bty1987/KeyCore/02-结构图纸/README.md

# 透明键盘 · 结构图纸说明（v5.0 · 侧磁 Maglev，2026-10-02）

> **★ 2026-10-07 重生成（现行，与下文冲突时以本条为准）**：
> 厚板 **v4 = 300.2×192×9**（与 PCB 同高同宽、四角 R4）**67 孔打穿**（2026-10-04 拍板），
> **孔心 = EDA 实测霍尔位 H01~H67**（用户拍板：v5.1"+4 预放偏置"弃用，霍尔位即键位）；
> 磁道 73 条（缝道 61 自空格侧板缘开通 + 行端道 12），边缘开口盲槽 z3~7 → **CNC**。
> 订购图 `07-PCB/output/厚板订购图-V6-打穿版-20261007.svg` 与 scad 同源同值。
> **CSV v5.2 的 x/y 列已过时**（键位其后多次手动下移，EDA=CSV−11.337mm），仅 **w_u 键宽列**可用；权威坐标 = EDA 实测霍尔位。

> **v5.0 大改版（2026-10-02 晚）**：复刻 Flux 键帽侧磁方案——每键 2×N52 4×2 嵌**键帽左右侧壁**（N 朝下），
> 霍尔移到**左侧磁铁正下方**，悬浮回弹改**键帽间侧壁互斥**，板侧磁铁全部取消，6×3 感应磁铁退役为备件。
> 旧版图纸（structure.scad 穿脖三件套 / 三段式键帽 / 框架板 / 厚板 v3.0 块底磁铁版）已全部删除，本目录即唯一现行版。

本目录 4 个文件，数据同源（同一份 67 键 CSV）：

| 文件 | 用途 | 状态 |
|---|---|---|
| `thickplate-v4.scad` | **厚板通孔板(67 孔打穿) + 键帽块 + 试装板**（thick_plate / keycap_block / test_plate，宽键 `-D key_wu=2.25` 等） | ✅ 2026-10-07 按 EDA 霍尔位重生成；v3 盲孔版已删 |
| `chassis-v3.2.scad` | 底壳 | ⚠ 仍为 314.2×201.4 时代值，待按 300.2×192（底壳 308.2×200）重生成 |
| `pcb-hall-positions.csv` | 键位表：**w_u 键宽列可用**；x/y 列已过时（权威 = EDA 实测霍尔位，与总装 HTML 零偏差） | ⚠ 坐标列过时 |

## 坐标系与朝向（关键，装反全盘错位）

- EDA 坐标系 = **立创EDA 顶视图（元件面朝上）**，原点 PCB 左下角，+x 向右，+y 向**后（Esc/宏排侧）**。
- PCB 外形 **300×192mm**（2026-10-07 定，与屏幕外围 300.2 同宽）；scad v4 坐标 = (EDA_x, 192 + EDA_y)（y-up 距前缘）。
- **霍尔位 = 键位**（孔心=霍尔位，2026-10-07 拍板）。布板/开孔以 EDA 实测霍尔位为准，禁止手填。

## 磁路 v5.4（全竖立 · 同排同向，10-02 修正）

| 项 | 规格 |
|---|---|
| 磁铁 | N52 4×2 圆盘 ×2/键，**竖立**嵌键帽左右侧壁（块外侧面水平打腔 Ø4.1、轴心高 2.05，横插、401 胶固定） |
| 位置 | 磁心 1u ±7.025、宽键 ±(wu×9.525−2.0−wall_t)；外壁 0.5mm；**完全嵌入帽内部**；极性 **同排全部同向**（帽间无互斥） |
| 帽缝 | 标准 2.05，无需加宽（帽间无作用力） |
| 托举/回弹 | **板上竖立磁铁（孔底，同排同向）与帽内磁铁竖直同向对斥** = 托浮+回弹（数量/层高 P0′ 定） |
| 感应 | 霍尔预放**键中心、偏上 +4mm**（CSV v5.1-prelim），一对磁铁一起感应合成变化；对称线上 B_z≈0，实测向左/右偏 2~4mm 扫最大点 → 定稿 v5.1-final |
| 兜底阶梯 | **单帽试产 → 双磁可行就批量；不行升三磁**：竖立×2 + 底心 1 颗 N 朝下 + 平贴对斥（v1.6 成熟路径） |

> **★ P0′ 闸门**：①单帽试产：托浮/回弹实测（板上竖立磁铁 vs 帽内磁铁，竖直对斥，数量/层高实排）②霍尔点位扫描（预放键中心偏上，向左右偏找最大点）③隔屏 Δ≥80mV。
> **P0′ 不过不许下 P2 的 ¥760**；点位定稿后重出 CSV v5.1。

## 装配顺序（厚板盲孔版）

1. 屏入底壳屏托圈（搭接 2mm/边，排线朝后入仓缺口）；
2. 键帽块从上方落入盲孔（先不装磁铁试滑配）；逐块压入侧壁磁铁（N 朝下，同向批量）点 401 胶；
3. 厚板坐入托肩（托肩面距屏 4mm = 静止悬浮气隙）；
4. PCB 落支撑柱（M2.5×6），USB-C 对左墙开口；霍尔面朝上；
5. 驱动板仓内平放、HDMI/12V 背墙出线；封箱前 OSD 设定一次（亮度 40~60%、HDMI、关自动关屏）。

## 待实测回改的 ★ 参数

- P0′ 三项实测 → 不过则磁路回退备选路线（见上）；
- `usb_y`、背墙出线口 `port_z`：PCB 布局定稿后改；
- 导出件重导：OpenSCAD 打开 `thickplate-v4.scad`（默认渲染 thick_plate 厚板；键帽块调用 keycap_block()，宽键 `-D key_wu=2.25`）→ 导出 STL。
