bty1987/KeyCore/layout-README.md

# layout.json · 唯一坐标数据源（v1.6 CSV 派生，2026-10-02）

## 坐标系（宪法，任何层级不得私设）
- 主坐标系：PCB 顶视图，原点 = PCB(300×146) 左下角，+x 向右，+y 向 Esc/宏行侧
- 所有层级的坐标必须从本文件派生，换算公式如下（写死，唯一合法换算）：

| 层级 | x | y | 备注 |
|---|---|---|---|
| PCB 霍尔位 | = x | = y | 零换算（画板对话直接用） |
| 显示层 px | (x−3.15)×6.537 | (183.3−y)×6.537 | 屏有效区 293.7×165.2 @1920×1080 |
| 厚板盲孔 | x+7.1 | 201.4−y | 板与 PCB 前缘平齐；matplotlib 绘图时 y 再用 (201.4−新y)=原 y（避免二次翻转） |

## 铁律
1. 任何一层重生成，必须从 layout.json 读坐标，禁止手算/重推
2. matplotlib 绘图注意 y 轴方向（本次订购图镜像事故的根因）
3. 坐标变更流程：改 CSV → 重生成 layout.json → 三层全部重跑生成器 → 渲染断言
