bty1987/KeyCore/00-文档/v3.0-总架构.md

> ⚠️ **历史文档（v3.0 时代，2026-10-02）——数据已过时**：文中尺寸（PCB 300×146/厚板 314×201）、盲孔结构、磁路 6×3 等均已被 v4/v5 方案取代。现行权威 = `07-PCB/output/画线总结-过程与经验-20261008.md` + `设计说明-KeyCore总装-20261007.md` + `02-结构图纸/thickplate-v4.scad`。本文仅作决策过程存档。

# KeyCore v3.0 · 三层一体架构 · 总说明

> 2026-10-02 定稿 · 磁铁腔镶亚克力孔底 · PCB 仅霍尔 · 键帽单键测试后再量产
> 数据源：`layout.json`（唯一权威，三层全部从此派生）

---

## 一、核心尺寸链（全部锁定）

| 参数 | 值 | 说明 |
|---|---|---|
| 键距 | **19.05 mm** | 行业标准，不可改 |
| 键帽块 | **16.5 mm** 方块 | 帽间缝 = 2.55 mm（≥2.0 要求 ✓） |
| 亚克力孔 | **16.9 mm** 方孔 R2 | 块 + 0.4 公差（0.2/边）；孔间筋 = 2.15 mm（≥2.0 ✓） |
| 磁铁规格 | **N52 4×2 圆片** | 全项目唯一规格（6×3 已退役） |
| 每键磁铁 | 块上 2 颗 + 板腔 2 颗 = 4 颗 | 悬浮 + 感应同颗双职 |
| 亚克力板厚 | **10.0 mm** | 孔深 6.5 + 底 3.5（含磁铁腔 2.2，顶面留 1.3） |
| PCB | 300 × 146 mm | 2 层 FR-4 1.6mm |
| 磁距（块底→霍尔） | 约 4.6~9.4 mm | 比 v2.0 近一半，信号预计 >60mV（待单键实测） |

---

## 二、三层结构

```
层① 亚克力板（10mm）—— 键帽载体 + 磁铁腔 + 顶面外观
    67 盲孔 Ø16.9 深 6.5（不打穿，底留 3.5）
    134 磁铁腔 Ø4.2 深 2.2（从背面铣，正对每孔 (±6,0)）
    磁铁腔嵌 4×2 N 朝上（与块底磁铁对斥）

层② IPS 屏（2.5mm）—— 键位字符显示
    13.3 寸 1080P，有效区 293.7 × 165.2 mm

层③ 霍尔 PCB（1.6mm）—— 按键检测
    67 颗 SOT-23 霍尔（每键 1 颗，位于键心偏 (−6,0)）
    9 片 74HC4051 多路复用 → ESP32-S3 → USB HID
    ★ PCB 上无任何磁铁（磁铁全在亚克力板里）
```

### 磁路原理（一句话）

键帽块底面两颗 4×2（N 朝下）→ 穿过亚克力孔底 1.3mm + 空气 → 与板腔内两颗 4×2（N 朝上）**对斥** → 斥力把键帽块顶在孔内上止位（悬浮静止），按压压缩斥力，松手弹回。霍尔在左磁铁正下方感知移动磁场变化。

---

## 三、坐标体系（唯一数据源）

```
layout.json ← 唯一权威
├── PCB 霍尔位 = 每键 (键心x − 6, 键心y)
├── 亚克力磁腔 = 每键 (键心 ±6, 键心y)  
└── 显示层字符 = 每键键心（换算至屏物理尺寸）

坐标转换公式（固定）：
  亚克力孔心 = (键心x + 7.1, 键心y + 23.1)    （板坐标）
  磁腔中心   = (孔心 ±6, 孔心y)               （同上）
  显示层 px  = ((键心x − 3.15) × 6.537, (183.3 − 键心y) × 6.537)
```

---

## 四、采购/制造清单

| 件 | 规格 | 渠道 | 状态 | 预估 |
|---|---|---|---|---|
| 亚克力主板 | 314.2×201.4×10mm + 67孔 + 134磁腔 | CNC 定制 | ⬜ 待下单 | ¥200~350 |
| 单键测试样块 | 40×40×10mm + 1孔 + 2磁腔 | 同批切割 | ⬜ 随主板 | +¥20 |
| PCB | 300×146mm ×5 片 + SMT | 嘉立创 | 🔄 画板中 | ¥760 |
| 键帽块 ×67 | 16.5×16.5×7.5 透明树脂 | 三维猴 3D 打印 | ⬜ 测试后下单 | ¥350~550 |
| 磁铁 N52 4×2 | 268 颗（在手 300 ✓） | 已到货 | ✅ | ¥0（补 ¥0） |
| 霍尔 HAL49E SOT-23 | 67×5 = 335 | SMT 随 PCB | 🔄 画板中 | 含 PCB |
| ESP32-S3-WROOM-1 | 5 | SMT 随 PCB | 🔄 | 含 PCB |
| 底壳 | 3D 打印 | 待画 | ⬜ | ¥150 |

---

## 五、测试流程（不可跳过）

```
亚克力到货
  ↓
单键测试（用样块）
  · 磁铁嵌入板腔（N 朝上）
  · 键帽块（手切亚克力方块即可）底面贴两颗磁铁（N 朝下）
  · 霍尔贴样块底面左磁腔正下方
  · 磁铁靠近/远离 → 串口看 Δ
  ↓
Δ ≥ 30mV？
  ├── 是 → 批量键帽（两磁版 keycap-block-final.stl）→ 装配 → 全键联调
  └── 否 → 退三磁铁方案（v1.9：感应磁铁独立、霍尔键心正下）→ 重出键帽 STL → 再测
```

---

## 六、已废弃方案（留档不删，防止回退）

| 版本 | 方案 | 废弃原因 |
|---|---|---|
| v1.6 | 盖板开孔穿脖子 + 三磁铁底面中心 | 孔洞体验差、磁铁挡字符光路 |
| v1.8 | 两颗对角悬浮 + 霍尔 rep1 正下方 | 霍尔与 PCB 磁铁撞位（同一物理点） |
| v2.0 | 两颗对角 + 霍尔内移 4mm 交替 | 实测 Δ48mV 可用但架构不如 v3.0（PCB 仍需贴 134 磁铁） |
| 三段式键帽 v2 | 头/腰法兰/裙身 | 键帽异形复杂、观感不如整块厚板 |
