bty1987/KeyCore/00-文档/亚克力订购指导.md

> ⚠️ **历史文档（v3.0 时代，2026-10-02）——数据已过时**：文中尺寸（PCB 300×146/厚板 314×201）、盲孔结构、磁路 6×3 等均已被 v4/v5 方案取代。现行权威 = `07-PCB/output/画线总结-过程与经验-20261008.md` + `设计说明-KeyCore总装-20261007.md` + `02-结构图纸/thickplate-v4.scad`。本文仅作决策过程存档。

# 亚克力板订购指导 · v3.0（CNC 精密加工）

> 数据源：`02-结构图纸/thickplate-v30.scad` / `02-结构图纸/pcb-hall-positions.csv`
> 随单文件：`05-效果图/厚板订购图.png`（工程图）+ `02-结构图纸/export-thickplate-v30.stl`（3D 参考）

---

## 一、订购内容（两件同批）

### 件 1：主板（1 件）

| 参数 | 值 | 公差 |
|---|---|---|
| **材质** | 透明亚克力（PMMA）**浇注板** | — |
| **外形** | 314.2 × 201.4 mm（四角 R4 圆角） | ±0.3 |
| **板厚** | **10.0 mm** | ±0.2 |
| **盲孔** | 67 个 **16.9 × 16.9 mm 方孔，角 R2** | 边长 +0.1/−0 |
| **孔深** | **6.5 mm**（从顶面往下，不打穿） | +0.2/−0 |
| **孔底厚度** | 3.5 mm（= 板厚 10 − 孔深 6.5，不打穿） | — |
| **磁铁腔** | 每孔底 2 个 **Ø4.2 mm 圆孔，深 2.2 mm**（从底面铣入） | 直径 +0.1/−0 |
| **磁腔底到孔底** | 1.3 mm（= 底厚 3.5 − 腔深 2.2，不可铣穿） | ≥1.0 |
| **表面** | 两面钻石抛光，孔壁火抛光 | — |
| **孔位** | 按 DXF/坐标表（键距 19.05mm 阵列） | **±0.15** |

### 件 2：单键测试样块（1 件）

| 参数 | 值 |
|---|---|
| 外形 | 40 × 40 × 10 mm（无圆角） |
| 盲孔 | 1 个 16.9×16.9 R2，深 6.5（同主板） |
| 磁铁腔 | 2 个 Ø4.2 深 2.2（同主板，位置在孔心 ±6mm） |
| 材质/表面 | 同主板 |

---

## 二、孔位坐标（67 孔 + 134 磁铁腔）

**坐标原点 = 板左下角**（非 PCB 坐标，差一个偏移量）。

### 换算公式

```
板孔中心 x = PCB hall_x + 6 + 7.1 = CSV 键心x + 7.1
板孔中心 y = PCB hall_y + 23.1 = CSV 键心y + 23.1
```

### 坐标表

从 CSV `pcb-hall-positions.csv` 中读取 `hall_x`/`hall_y`，套入上式。

或直接从以下文件获取已换算的坐标：
- `02-结构图纸/frame-plate-coords.scad`（OpenSCAD 数组，每行一个孔）
- `02-结构图纸/export-thickplate-v30.stl`（3D 模型，可用 CAD 软件测量）

### 磁铁腔位置（每孔 2 个）

```
磁腔 1 中心 = (板孔中心 x − 6, 板孔中心 y)
磁腔 2 中心 = (板孔中心 x + 6, 板孔中心 y)
```

**所有 67 孔的磁腔方向统一**：左右各一个，不交替不镜像。

---

## 三、关键公差（厂家必须确认）

| 项目 | 公差 | 为什么重要 |
|---|---|---|
| 孔位中心距 | **±0.15 mm** | 偏了按键歪、磁路错位 |
| 孔边长 | 16.9 **+0.1/−0** | 太大键帽晃、太小键帽卡死 |
| 孔深 | 6.5 **+0.2/−0** | 太深板底穿、太浅键帽凸太多 |
| 磁腔直径 | Ø4.2 **+0.1/−0** | 太大磁铁松脱、太小压不进 |
| 磁腔深度 | 2.2 **+0.2/−0** | 太深穿入孔底（磁铁会突出碰键帽） |
| 磁腔底到孔底面 | **≥1.0 mm**（设计 1.3） | 太薄受力断裂 |

**⚠️ 最容易做错的地方：**
1. **盲孔不打穿**——底面必须保留 3.5mm 整体厚度
2. **磁铁腔从底面铣**，不是从顶面——方向搞反整板报废
3. **浇注板不要挤出板**——挤出板内应力大，CNC 后翘曲

---

## 四、随单发送厂家

| 文件 | 说明 |
|---|---|
| `05-效果图/厚板订购图.png` | 工程图（正视+剖面+参数表） |
| `02-结构图纸/export-thickplate-v30.stl` | 3D 模型（可旋转查看磁腔位置） |
| 本文档 `00-文档/亚克力订购指导.md` | 完整规格说明 |

---

## 五、验收清单（到货后逐项检查）

- [ ] 板厚 10.0mm（卡尺量，±0.2）
- [ ] 孔深 6.5mm（深度尺或磁铁试插）
- [ ] 孔底未打穿（手指摸底面应平整无凹陷）
- [ ] 磁腔 Ø4.2×2.2（4×2 磁铁轻压入，不松不紧）
- [ ] 磁腔底面距孔底 ≥1.0mm（从底面孔位透光看，不应看到磁腔底部）
- [ ] 67 孔位置抽样（用键帽块试插 3~5 个孔，应顺畅滑动无卡涩）
- [ ] 测试样块同批验收

---

## 六、参考价

| 件 | 预估 |
|---|---|
| 主板（300×200×10 + 67 孔 + 134 腔 + 抛光） | ¥200~350 |
| 测试样块 | +¥15~25 |
| **合计** | **¥215~375** |

超 ¥400 换店。
