bty1987/KeyCore/01-方案/复刻实操方案.md

> ⚠️ **方案演进存档**：本文记录 2026-10-02 的方案决策过程。现行定稿见 `07-PCB/output/设计说明-KeyCore总装-20261007.md`（层叠/分区/引脚）与 `07-PCB/output/画线总结-过程与经验-20261008.md`。

# 透明屏幕键盘 · 复刻实操方案

> **v2.0 · 侧磁 Maglev 改版（复刻 Flux）** · 2026-10-02 晚：用户拍板**放弃"中心 6×3 感应 + 帽底/板侧对斥悬浮"**，直接复刻 Flux 键帽侧磁方案——
> **每键 2×N52 4×2 嵌键帽左右侧壁（N 朝下，库存 300 颗覆盖），霍尔移到每键左侧磁铁正下方（hall_x=mag1_x），悬浮回弹=键帽间侧壁互斥，板侧磁铁全部取消，6×3 退役为备件。**
> 同步改版：结构走**厚板盲孔**（314×201×9 亚克力单块 + 67 键帽块，今日拍板）；CSV 重生成 **v5.0**；29 个旧版图纸文件删除；
> 今日实测背书：方案 D（霍尔对准磁铁）全幅 **1163mV** vs 方案 A（对角远置）仅 97mV——"霍尔贴磁铁"是信号量的关键。
> **★ P0′ 实测（2026-10-03 改序）**：厚板 + PCB **先设计下单**（亚克力订购图 v5.3 + KeyCore.kicad_pcb 已就绪），**到货后用实物做单帽三项实测**——托浮/回弹、霍尔点位、隔屏 Δ；不过线走三磁兜底（底心磁铁贴亚克力孔底，订购图已标注，PCB 无需改板），备选路线见 §5。
>
> **v1.3 · 锁定配置 + 复审修正版** · 2026-09-20
> 参考：[in外设 手搓单键验证](https://www.douyin.com/video/7527902453442956602) · [马同学 800 元复刻](https://www.douyin.com/video/7675649721012129076)（原品 = Finalmouse 屏下键盘）
>
> **v1.6 · 文档全面同步** · 2026-09-28 深夜：67 键口径贯穿全文档（检测/采样/Layout/固件通道/附录C），磁距口径 9.1→6.1mm，宏行行距缩至标准 19.05mm，动效区排版定稿（大时钟居中范式，效果图用户验收），首台全包口径更新 ≈¥2,100。
> **v1.5 · 宏行定稿** · 2026-09-28：用户拍板"预留功能键=物理键位，Esc 上方加一排但只要几个"→ **宏行 M1~M6 紧靠左侧**（M1 正对 Esc 上方 25.05mm，6×1u，键区内居中 x_u=6~9），全链同步：CSV 67 键、PCB 300×**146**（加深容纳宏行，主控条移至 PCB 前段）、盖板孔阵 67、4051 ×9、键帽 67、磁铁 335；**动效区 4 个虚拟"预留"按钮移除**（用户原则：显示与实体必须一致，不对应=浪费）；固件 keymap 65→67 通道；渲染验证 67 键满铺 ✓。成本增量 ≈+80 元（一次性），对比将来改板 ≈¥800+。
> v1.3 变更（全案复审）：修正悬浮堆叠（旧版按键到底会撞屏 1.6mm，现静止气隙4=行程3+安全1）；CSV 修复上下镜像；悬浮方案落定为**磁斥对**（帽底对角4×2×2 + PCB面同位对斥）；感应磁铁默认升 6×3；扫描率从宣传口径修正为实测口径（100~150Hz，500Hz 需 DMA）；PCB 改 300×122（后条带放主控）；驱动板仓明确在 PCB 下方；**全部结构图纸已用 OpenSCAD 实际编译并导出 STL/DXF 验证**（见 ../02-结构图纸/ 与附录 C）。9-28 屏实测回填（2.5mm/293.7×165.2/含电源）：底壳盖板重导出为 314×201、磁距缩至 9.1mm；PCB 摆位改由屏尺寸**推导**（杜绝手填错位）；键帽直壁参数化**真修并导出验证**（1u=18.05×18，宽键 41.86/118.06 实测 bbox）。

---

## 0. 拍板配置（唯一方案，没有"或者"）

| 项 | 拍板 |
|---|---|
| 配列 | 61 键 60% + **宏行 M1~M6**（Esc 上方，紧靠左侧，物理键位）= 67 键 |
| 显示 | **13.3 寸 IPS 1080P 裸屏 + HDMI 驱动板，屏幕朝上 = 键盘顶面**，键帽浮在屏面上，字透过键帽可见 |
| 主控 | ESP32-S3-WROOM-1-N4 |
| 检测 | HAL49E 线性霍尔 ×**67**（**每键左侧磁铁正下方**，v5.0）+ 74HC4051 ×**9** 复用成 1 路 ADC，行程 2~3mm，键帽间侧磁回弹 |
| 键帽 | 光固化高透树脂代打，**块状帽**（厚板盲孔嵌帽），每键侧壁嵌 2×N52 4×2（N 朝下）；不打字（字由屏显示） |
| 固件 | PlatformIO + Arduino-ESP32，USB HID，全键扫描 100~150Hz（打字级；电竞 500Hz+ 需 DMA 连续采样，属 P5 可选项） |
| 渲染 | 先笔记本 HDMI 直连；香橙派 Zero 3 独立运行为可选项（§10） |
| 成品 | USB-C 打字即插即用，通电 1 小时无误触，**首台全包 ≈¥2,100，定型后单台 ≈¥1,250** |

---

## 1. 架构（一张图 + 一段话）

```
z=34.6 ┌─────────────────────────────────────────┐ 顶
       │ ① 厚板 9mm 亚克力（67 盲孔嵌帽，顶露帽 1.5）│
z=25.6 ├─────────────────────────────────────────┤ ← 板底=块底（托肩承板）
       │ ② 键帽块 17×17×7.5：左右侧壁各嵌 4×2 ×1   │ ← 磁心高块底 1.05，N 朝下
       │    侧壁互斥=居中+回弹（邻键磁距 8.05mm@1u） │   行程 3mm
z=21.6 ├─────────────────────────────────────────┤ ← 屏面（块底静止=气隙4mm，按到底距屏1mm）
       │ ③ IPS 屏体 2.5mm（磁场穿透无阻碍，P0 验证） │
z=19.1 ├─────────────────────────────────────────┤ ← 空气隙 2mm（温漂防线）
       │ ④ 霍尔 PCB 1.6mm（霍尔=左侧磁铁正下方）     │    磁心-霍尔 ≈8.5 → 5.5mm
z=15.5 ├─────────────────────────────────────────┤ ← PCB底；下方 12.5mm 驱动板仓
       │ ⑤ HDMI驱动板（仓内平放，背墙出线）          │
z=3.0  └─────────────────────────────────────────┘ 底
       外廓 314×201，总高 ≈34.6mm（与 v1.6 持平）
```

原理一句话：键帽侧壁的磁铁被屏后霍尔感知（屏不导磁，隔屏检测 P0 已实锤；霍尔对准磁铁是信号关键——方案 D 实测全幅 1163mV）；相邻键帽侧壁磁铁互斥提供居中与回弹（复刻 Flux Maglev）；屏在键帽正下方画键位字符，透过透明帽身可见；按键数据走 USB HID 给电脑，同时串口发给渲染端做高亮联动。

---

## 2. 总账单（全项目唯一一张 BOM 表）

**价格纪律（三条，替代所有"区间"）：**
1. 每行锁**锚价**（2026-09 淘宝/立创市场价中位）。实付超过锚价 **15% → 换店重搜，不加价**；
2. 主线没有可选项——想升级看 §10，不影响本表；
3. 按 P0→P1→P2→P3→P4 顺序花钱，**上一阶段验收过了才花下一阶段的钱**。

| 阶段 | # | 物料 | 数量 | 锚价 | 小计 | 渠道 |
|---|---|---|---|---|---|---|
| P0 | 1 | ESP32-S3 开发板（USB-C，N8R2） | 1 | 40 | 40 | [淘宝](https://s.taobao.com/search?q=ESP32-S3%E5%BC%80%E5%8F%91%E6%9D%BF%20USB-C) |
| P0 | 2 | HAL49E 霍尔（SOT-23） | 5 | 1 | 5 | [立创商城](https://so.szlcsc.com/global.html?k=HAL49E) |
| P0 | 3 | **N52 磁铁**：6×3×100（感应）+ 4×2×300（悬浮对）——9-28 已实拍 ¥121.2；8×3 备胎砍掉，弱信号应急=双 6×3 叠用 | 400 颗 | 121 | 121 | [淘宝](https://s.taobao.com/search?q=N52%E5%9C%86%E5%BD%A2%E5%BC%BA%E7%A3%81%E9%93%816x3%204x2%208x3) |
| P0 | 4 | 面包板 + 杜邦线套装 | 1 | 20 | 20 | 淘宝随手 |
| P0 | 5 | 透明亚克力 4mm / 5mm 各一片（模拟屏体与盖板） | 2 | 6 | 12 | [淘宝](https://s.taobao.com/search?q=%E9%80%8F%E6%98%8E%E4%BA%9A%E5%85%8B%E5%8A%9B%E6%9D%BF4mm) |
| **P0 小计** | | | | | **171** | |
| P1 | 6 | **13.3 寸 IPS 1080P 裸屏 + HDMI 驱动板套件**（已并入首单；实测 300.2×187.4×**2.5mm**，有效区 293.7×165.2，含 12V1A 电源/排线，出厂预插线） | 1 | 289（实拍） | 289 | [淘宝](https://s.taobao.com/search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) |
| P1 | 7 | **✅已拍** HDMI 线 1m（4K 圆线） | 1 | 10 | 13.87 | 淘宝 |
| P1 | 7b | ~~12V 电源适配器~~（**套件已含 12V1A**，免购；13.3 屏功耗 <10W，1A 够用） | — | 0 | 0 | [淘宝](https://s.taobao.com/search?q=12V%202A%20%E7%94%B5%E6%BA%90%E9%80%82%E9%85%8D%E5%99%A8) |
| **P1 小计** | | | | | **303** | |
| P2 | 8 | PCB 打样：2 层 / 1.6mm / **300×146mm**（v1.5 加深容纳宏行）/ 黑色阻焊白字 / 无铅喷锡 | 5 片 | 170 | 170 | [嘉立创](https://www.jlc.com) |
| P2 | 9 | SMT 经济贴片工程费（顶部贴片，1 单） | 1 | 150 | 150 | 同上下单勾选 |
| P2 | 10 | HAL49E 霍尔 | **67×5=335** | 0.8 | 268 | [立创商城](https://so.szlcsc.com/global.html?k=HAL49E) |
| P2 | 11 | 74HC4051D（SOIC-16） | **9×5=45**（65→67 通道） | 0.5 | 22 | [立创商城](https://so.szlcsc.com/global.html?k=74HC4051) |
| P2 | 12 | ESP32-S3-WROOM-1-N4 | 5 | 15 | 75 | [立创商城](https://so.szlcsc.com/global.html?k=ESP32-S3-WROOM-1) |
| P2 | 13 | USB-C 母座 / ME6211C33 / 0805 阻容 / 轻触按键 | 5 板份 | 15/板 | 75 | 立创EDA 贴片库内选 |
| **P2 小计** | | | | | **715** | |
| P3 | 14 | 键帽代打：高透光敏树脂（先 5 个试产再批量） | **67**（61+宏 6） | 8 | 536 | [三维猴](https://www.sanweihou.com) / [淘宝](https://s.taobao.com/search?q=3D%E6%89%93%E5%8D%B0%E4%BB%A3%E6%89%93%20%E9%80%8F%E6%98%8E%E6%A0%91%E8%84%82) |
| P3 | 15 | 磁铁：**P0 已购足**（v5.0 侧磁只用 4×2×134，已购 300 覆盖；6×3 退役为备件），无追加 | — | — | 0 | — |
| P3 | 16 | ~~亚克力盖板 5mm 定制切割~~ → **厚板 9mm 定制**（314.2×201.4，67 盲孔由 CNC/激光+铣床，上传 DXF/STL） | 1 | 100 | 100 | [淘宝](https://s.taobao.com/search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) |
| P3 | 17 | 401 胶 + 透明光油 + Bumpon 防刮垫 | 1 套 | 40 | 40 | 淘宝随手 |
| **P3 小计** | | | | | **610** | |
| P4 | 18 | 底壳 3D 打印（黑色） | 1 | 150 | 150 | 三维猴/淘宝 |
| P4 | 19 | 铜柱螺丝杜邦杂项 | 1 套 | 30 | 30 | 淘宝随手 |
| P4 | 20 | DS18B20 ×2 + 线材（温补） | 1 套 | 15 | 15 | 立创/淘宝 |
| **P4 小计** | | | | | **195** | |
| **首台全包** | | | | | **≈2,100**（67 键版） | |
| 定型后单台复刻 | | 元件 83 + 板 30 + 屏 289 + 键帽量产 350 + 磁铁 89 + 盖板/壳 320 | | | **≈1,150/台** | |

> **关于 IPS 价格跨度**：市场价 150~300 的散布来自三个变量——分辨率（1280×800 便宜、1080P 贵）、整机便携屏 vs 裸屏套件、带不带触摸。本表锁的是「**1080P + 裸屏套件 + 不带触摸**」这个组合，锚价 220；低于 160 的大概率是 800P 低分屏，高于 260 的多半塞了触摸，按规则 1 都不追。

---

## 3. 阶段执行（每阶段：做什么 / 验收什么 / 动用多少钱）

| 阶段 | 动作 | 验收标准 | 金额 |
|---|---|---|---|
| **P0**（1 周末） | 面包板接 ESP32-S3 + 1 颗霍尔 + 磁铁，**用真屏**（首单已并购）夹出「屏体 + 夹层」的真实层距，串口看行程曲线；同步测悬浮对手感（4×2 对斥 5~8mm 间距） | 磁铁 10mm→6mm：曲线单调、无毛刺、Δ≥80mV（弱则当场换 8×3 对比）；悬浮对手感 ~30-60g 压感；磁铁不吸附屏背面（=背面非铁质）。**✅ 已过（Δ+1023mV，9-29 报告）** | 474（含 P1 屏，实付口径） |
| **P0′**（**厚板+PCB 到货后**第一步，2026-10-03 改序） | **真实厚板 + 真实 PCB + 1 颗试产帽**实测：①**托浮/回弹**——板上竖立磁铁 vs 帽内磁铁竖直对斥，验证托浮跟手、定数量/层高；②**霍尔点位**——预放键中心偏上 +4mm（CSV v5.1-prelim），向左/右偏 2~4mm 扫最大点；③**隔屏信号**——按层高走行程曲线。**裁决：双磁可行 → 批量双磁；不行 → 三磁兜底**（底心 1 颗 N 朝下 + 底心对斥，PCB 丝印已预留，无需改板） | ①托浮+回弹跟手 ②点位可复制 ③曲线单调 Δ≥80mV。**不过线走三磁，硬件不改板** | 0（除试产帽外全部到货物料） |
| **P1**（半周末） | IPS 套件点亮，笔记本 HDMI 放全屏键位图，用几颗临时透明帽/亚克力块比划对齐（物料已随首单到位，无新支出） | 亮度观感满意，键位图坐标可对齐实体网格。**✅ 已过（9-28 验收）** | 0 |
| **P2**（2~3 周，含物流） | 程序化生成 + EDA 收尾布线 → 嘉立创打样 + SMT（§4）→ 收货验板。**2026-10-03：KeyCore.kicad_pcb 已发射（放置/母线✓，剩余布线 EDA 收尾）** | 3.3V 正常；磁铁扫过 67 通道逐一有响应 | 715 |
| **P3**（与 P2 并行） | OpenSCAD 建模 → 试产 5 帽 → 验手感 → 批量 61 帽 + 镶磁铁 + 盖板下单（§5） | 试产帽悬浮行程 2~3mm、不刮屏 | 610 |
| **P4**（1~2 周末） | 整机装配 + 固件联调 + HID 打字 + 开机校准 | 接电脑打字无误触，屏幕联动高亮 | 195 |
| **P5**（持续） | 温漂校准打磨、RT 快速触发、动效、拍复刻对比视频 | 通电 1 小时误触发 = 0 | 已含 |

时间线：兼职 **5~7 个周末**。

---

## 4. PCB 打版七步（P2 详细流程）

> 立创EDA（浏览器免费，Mac 友好）+ 嘉立创，EDA 与打样厂一体。华秋等价（马同学用的华秋）。

1. **注册** [pro.lceda.cn](https://pro.lceda.cn)，工程存云端。
2. **器件全选"立创贴片库"**（保证 SMT 能贴）：HAL49E SOT-23-3、74HC4051D SOIC-16、ESP32-S3-WROOM-1-N4、USB-C 16P 母座、ME6211C33、0805 阻容。
3. **原理图**：61 霍尔 OUT → 8 片 4051 的 X0~X7（64 通道用 61）；8 片地址线 A/B/C 并联 → 3 个 GPIO，E 接地，Z 输出并联 → GPIO4（ADC1）；Z 与 ADC 间 100Ω + 100nF；ESP32 最小系统（LDO/EN/BOOT/USB-C，Strapping 照抄模组手册典型电路）；可选 DS18B20 ×2 与背光 PWM 脚。
4. **Layout（★v4 形态改版 10-02 拍板）**：板框 **300×172mm**（+26 在宏行侧；空格排=键盘最底边，下方零器件；**元件带全部在宏行侧硬件带 EDA y136~172**：9×4051 排 y143 + ESP32(280,150) 天线朝顶边（禁布区 x271~289/y159~169 无铜无孔）+ USB-C 顶边 x=150 出线 + LDO/按键/阻容；前段 y0~23 只留安装孔与 3V3 Lane；**4 层板**（GND/3V3 内层平面）。屏内自定义区（屏盖键区外的38.3mm）与屏外硬件带（26.4mm）分层放玩法与硬件，互不占用）；67 霍尔按 [pcb-hall-positions.csv](../02-结构图纸/pcb-hall-positions.csv) **v5.0** 坐标放置（**霍尔=每键左侧磁铁正下方 hall_x=mag1_x**；坐标系=EDA顶视图，+y 向 Esc/宏行侧）；模拟区铺地完整；ESP32 天线区悬空；丝印白字标键位；黑色阻焊哑光。~~悬浮磁铁粘接点~~（v5.0 板侧无磁铁，删）。
5. **DRC → 一键导出** Gerber + BOM + 坐标文件。
6. **下单**：2 层 / 1.6mm / 无铅喷锡 / 黑色阻焊白字 / 5 片；SMT 勾顶部贴片、经济型、传 BOM+坐标。3~7 天到货。
7. **验板**：目检 → 3.3V/GND 不短路 → 烧 blink → 刷 ADC 扫描器，磁铁逐键晃过。

**采样细节**（v1.3 诚实口径 + v2.0 信号量更新）：4051 切换后 ~10µs 稳定，弃第一次采样取第二次；`analogReadMilliVolts()` 单次 ~50-100µs → 67 键一轮 **8~11ms ≈ 100~140Hz**，打字绰绰有余（人手最快连击 ~20Hz）。要 RT 电竞级 1kHz 需 P5 改 DMA 连续采样（esp_adc continuous mode，工程量半天）。信号量（v5.0）：4×2 侧壁磁铁磁心距霍尔 ≈8.5→5.5mm，按 P0 实测外推 Δ≈250~400mV（方案 D 同数量级实测全幅 1163mV 背书），余量充足；**P0′ 以实测为准，弱则侧壁腔加深换 6×3 或双 4×2 叠**。

---

## 5. 键帽与结构（v2.0 厚板盲孔 + 侧磁 Maglev）

**需要 3D 打印，必须光固化高透树脂（FDM 透明 = 毛玻璃，否掉）；不买打印机，代打。厚板为亚克力定制。**

- **结构（10-02 拍板"简单的一块更厚的亚克力"）**：314.2×201.4×9mm 透明亚克力单块，67 个盲孔（17.6² 方孔 R2、深 6.5 不打穿），键帽块（1u 17×17×7.5，宽键加宽）落入孔中滑动，顶露板面 1.0~1.5mm。图纸 `../02-结构图纸/thickplate-v3.scad`（part=plate/block/test_plate）+ `chassis-v3.1.scad`。
- **侧磁（v5.3 全竖立+贴缝）**：每键 2×N52 4×2 圆盘**竖立**嵌左右侧壁——块外侧面水平打腔（Ø4.1，轴心高 2.05）横插磁铁**完全嵌入帽内**，**同排全部同向**（帽间无互斥；401 胶固定）；外壁 **0.5mm** → **极面间隙 ≈3.0mm**（=2.05 帽间隙+2×外壁；旋钮 wall_t：0.25→2.55mm、0→2.05mm 磁铁齐平——**"2mm 以上即可，无需 5mm"**）；磁心 1u ±7.025、宽键 ±(wu×9.525−2.0−wall_t)。
- **几何红线**：孔间壁只有 1.45mm，Ø4 竖立磁铁**放不进键间的板上**——板侧对斥只能平贴孔底/PCB 面；竖立对竖立的对斥只发生在键帽之间。
- **悬浮与回弹（v5.4 口径）**：同排磁铁全部同向、帽间无互斥；**托浮/回弹 = 键帽磁铁 与 板上竖立磁铁（孔底，同向）的竖直对斥**——板上磁铁同样竖着放，与帽内磁铁逐对竖直对置，压压缩距、松手回弹（竖直弹簧）。帽间缝即标准 2.05，无需加宽。行程 3mm，按到底块底距屏 1.0mm。层高配比 P0′ 实排校验。
- **霍尔摆位（v5.2 变更）**：竖立磁铁**正下方 B_z≈0**——P0′ 用 TO-92 直插现场扫偏位最大点（预计在磁极面侧下方 2~4mm），点位定稿后重出 CSV v5.1，再画 P2 板。
- **兜底阶梯（10-02 拍板）**：单帽试产 → **双磁方案可行就批量**；不行 → **三磁兜底**：竖立×2（保留侧向居中）+ 底心 1 颗（4×2 或 6×3，N 朝下）+ 孔底/PCB 平贴对斥——底心磁铁恢复"霍尔正对+垂直对斥"的 v1.6 成熟路径，信号/悬浮全部有实测背书。
- **防刮**：键帽块底四角 0.3mm Bumpon（按到底距屏 1.0mm 的净距来源）。
- **手感调节**：偏轻 → 磁铁换 6×3 或双 4×2 叠（腔加深 2.1→4.2）；偏重 → 减胶面/微扩孔距。
- **极性实操**：侧壁磁铁全部"同一面朝下"批量压入；装好后任取两邻帽感受互斥即为对（相吸则翻整批，不用逐颗验）。

---

## 6. 固件骨架（P2 等板期间写完）

VSCode + PlatformIO + Arduino-ESP32：

```cpp
#include <USB.h>
#include <USBHIDKeyboard>
USBHIDKeyboard Keyboard;

const int ADDR[3] = {5, 6, 7};   // 4051 A/B/C
const int ADC_PIN = 4;
uint16_t baseline[64];
uint8_t  keyCh[67]  = { /* 通道映射, 含 M1~M6 */ };
uint8_t  keyCode[61]= { /* HID 键码 */ };

int readCh(uint8_t ch) {
  for (int i = 0; i < 3; i++) digitalWrite(ADDR[i], (ch >> i) & 1);
  delayMicroseconds(20);
  analogRead(ADC_PIN);                       // 弃样
  return analogReadMilliVolts(ADC_PIN);
}

void loop() {
  static uint32_t t = 0;
  if (millis() - t < 8) return;              // ~120Hz 全键扫描（打字级）
  t = millis();
  for (int k = 0; k < 61; k++) {
    int travel = readCh(keyCh[k]) - baseline[keyCh[k]];
    bool pressed = travel > pressThreshold;  // 如 60mV，可调
    // TODO: 迟滞 + RT 快速触发 + 上报/释放
  }
}
```

- 开机静置 3 秒采基线存 NVS；空闲键缓漂慢速跟随（温漂第一道防线）；
- RT 算法抄 [Rapid-trigger-minipad](https://github.com/RQNG/Rapid-trigger-minipad)；
- USB CDC 串口把键程发渲染端做联动。

---

## 7. 显示层

- **键位页**：HTML 全屏（F11），61 个键位块绝对定位——坐标由 19.05mm 键距 × 屏幕物理尺寸换算，脚本与 `keymap.h` 同源生成，保证字符对齐实体键。**9-28 定稿：键区下沉**（屏上边距 54.95 / 下边距 15mm，顶部动效区 ≈55mm）——盖板孔阵/PCB 摆位/keymap 三方同源联动，已实测断言零重叠。动效随便加（按键涟漪、键程映射亮度、呼吸壁纸）。
- **独立运行（可选，§10）**：香橙派 Zero 3 + Armbian + Chromium kiosk 自启；键盘插香橙派，`evdev` → WebSocket → 页面高亮。

---

## 8. 温漂对策（三行）

1. **物理**：背光按需调低（IPS 不需要高亮）、屏与霍尔 PCB 间留 2mm 空气隙、底壳散热孔；
2. **软件**：开机校准基线 + DS18B20 温补 + 空闲键慢速跟随；
3. **验收**：通电 1 小时误触发 = 0。

（v1.1 的"透明屏发热"头号难题已随 IPS 方案消失，此节只是兜底。）

---

## 9. 风险表

| 风险 | 对策 |
|---|---|
| 隔屏信号弱 | 4×2 侧磁磁心-霍尔 ≈8.5→5.5mm，外推 Δ≈250~400mV（方案 D 实测背书）；仍弱 → 侧壁腔加深换 6×3 / 双 4×2 叠 |
| **侧磁静态托举不足（P0′ 可能发现）** | 键帽间互斥的垂直分量在静止位=0，托举靠盲孔+回复力；回弹实测 <1.5×帽重 → 磁铁 45° 斜嵌（§5 备选 1）或恢复板侧对斥（备选 2） |
| **邻键串扰（按一键邻帽跟着动）** | P0′ 实测 Δ；软件端基线校准+迟滞吸收小幅串扰；硬件端=加大邻距（仅宽键端点磁铁）或改斜嵌 |
| 键帽刮屏 | 按到底距屏 1.0mm + Bumpon 0.3；装配前逐帽点检四脚垫 |
| 块帽在盲孔中侧倾/晃 | 孔 17.6 vs 块 17.0（单边 0.3 公差）+ 侧磁居中力 ~6g/侧；仍晃 → 孔收 0.1（P0′ 试装板验证） |
| 温漂 | §8 三条 |
| ADC 串扰 | 弃样 + RC 调整 + 降扫描率 |
| SMT 缺料 | 换等效 49E 型号；或手焊 SOT-23（2 小时） |
| 手感争议 | Finalmouse/Flux 同样争议，品类特性，接受 |

---

## 10. 可选升级包（主线不动，逐项加钱）

| 项 | 加价 | 说明 |
|---|---|---|
| 香橙派 Zero 3 独立渲染 | +130 | 摆脱笔记本，整机自成一体 |
| 路线 A：换 13.3 寸透明 LCD | +650 | 马同学式"全透明悬浮"观感；换屏即可，其余结构不动 |
| DRV5055A1 温补霍尔 | +250 | 温漂从软件兜底变硬件免疫 |
| 电容触摸屏 | +120 | 屏可直接点按（Finalmouse 同款玩法） |
| 47 键 40% 降配 | **-300** | 10.1 寸 IPS + 更小 PCB，省钱选项 |
| 升级 75% 配列 | +350 | 82 键（F 行+方向键），13.3 寸的键数上限，霍尔/键帽/PCB 加量。已评估，9-19 拍板不升级 |
| 升级 96% + 17.3 寸 | +750 | 98 键带小键盘（in外设 视频同款观感，其渲染端也是香橙派）。已评估，9-19 拍板不升级 |

> 9-19 配列评估结论：13.3 寸（有效区 294mm）按"键中心不出屏"原则，61 键余 8mm、68 键余 6.5mm、**82 键距屏边仅 4mm 为上限**；98 键需 ~372mm 有效宽，必须换 17.3 寸屏。固件侧 98 路扫描 330Hz 无压力，卡脖子的只有屏宽和钱。

---

## 11. 参考资源

- in外设 单键验证：[douyin.com/video/7527902453442956602](https://www.douyin.com/video/7527902453442956602)（IPS 朝上结构的依据）
- 马同学整机复刻：[douyin.com/video/7675649721012129076](https://www.douyin.com/video/7675649721012129076)（磁铁键帽细节）
- [oshwhub 立创开源广场](https://oshwhub.com) 搜「磁轴」：《4键 8K 磁轴小键盘》（STM32F205 + DRV5055A1）与本案同架构，原理图可抄
- [Rapid-trigger-minipad](https://github.com/RQNG/Rapid-trigger-minipad)（RT 算法）· [QMK 文档](https://docs.qmk.fm)
- 工具链：[立创EDA](https://pro.lceda.cn) · [嘉立创](https://www.jlc.com) · [立创商城](https://www.szlcsc.com) · [三维猴](https://www.sanweihou.com) · [香橙派](http://www.orangepi.cn)

---

## 附录：首单清单（**7/7 全部拍清，实付合计 ¥474.05**：屏 289 + S3 板 27.8 + 磁铁 121.2 + 霍尔 3.2 + 面包板/三线 15.12 + 亚克力 3.86 + HDMI 13.87）

> 合并逻辑：P0 本来就要测"磁铁隔真实屏体"的信号，真屏提前到手比亚克力模拟更严谨（还能当场查出屏背面是否铁质）；磁铁一次买齐全项目量。**P2（PCB ¥715）与 P3（键帽 ¥610）仍按闸门纪律，P0/P1 过关后才花。**

| # | 物料 | 渠道 | 锚价 |
|---|---|---|---|
| 1 | **✅已拍** ESP32-S3 开发板 N16R8 焊针版 | 淘宝 | 27.8（实付） |
| 2 | **✅已拍** 49E 霍尔 ×5（TO-92S 直插长脚，佳芯维） | 淘宝 | 3.2 |
| 3 | **✅已拍** N52 磁铁：6×3×100 + 4×2×300（¥121.2 实付；8×3 备胎砍，应急=双 6×3 叠） | 淘宝 | 121 |
| 4 | **✅已拍** 400孔面包板 + 母对母/公对公/公对母 40P 各一条（公对母=接线主力，公对公=跳电源轨） | 淘宝 | 15.12 |
| 5 | 透明亚克力 4mm/5mm 各一片（垫层距/临时结构用） | [淘宝](https://s.taobao.com/search?q=%E9%80%8F%E6%98%8E%E4%BA%9A%E5%85%8B%E5%8A%9B%E6%9D%BF4mm) | 12 |
| 6 | **13.3 寸 IPS 1080P 裸屏 + HDMI 驱动板套件**（下单前问两句：①屏体总厚度是否 ≤5mm；②背面屏蔽罩是铝还是铁——铁质要换选） | [淘宝](https://s.taobao.com/search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) | 220 |
| 7 | **✅已拍** HDMI 线 1m（4K 标准头圆线） | 淘宝 | 13.87 |
| ~~8~~ | ~~12V 电源适配器~~（**套件已含 12V1A，免购**） | — | 0 |

> P0 验收（周末下午出答案）：真屏叠夹层，磁铁 10mm→6mm 曲线单调 Δ≥80mV；4×2 对斥手感 30-60g；磁铁不吸屏背。

---

## 附录 C-2：工具采购清单（9-28 等货期置齐）

| 工具 | 参考价 | 阶段 | 说明 |
|---|---|---|---|
| 数字卡尺 | 20~40 | P0/P3/P4 | 量磁铁、屏厚、键帽公差 |
| 尖嘴钳 | 10 | P0 | 掰霍尔腿 L 形（距根 3mm 夹住再弯） |
| 万用表 | 30~80 | P2 必需 | 验板：3.3V 对地短路/电压/通断 |
| 焊台（**二合一烙铁+热风枪可选**：差价≤80 推荐二合一，热风枪用于验板返修/热缩管；风枪须数显温控、936 系通用头）+ 0.6mm 含铅焊锡 + 免洗助焊剂 + 吸锡带 | 180~280 | P2 | SMT 到板补焊/返修；等货期拿备用霍尔练手 |
| 镊子直头 | 5~15 | P2/P3 | 焊点检查、镶磁铁 |
| 工业酒精+棉签 | 10 | P2/P4 | 洗助焊剂 |

合计 ≈¥230~355。**明确不买**：回流炉（SMT 代工）、示波器（串口+万用表够）、3D 打印机（代打）、电动螺丝刀。热风枪不作单独采购项，随二合一焊台附带即可（9-28 修订）。
P0/P1 全程免焊；烙铁的第一次实战 = 验板补焊，提前用备用霍尔练两把。

**最低采购路线（9-28 补充，不想置全套工具时）**：只买万用表（¥30-80），其余全部滞后采购。无工具可行边界：P0-P1 零工具（霍尔腿可面包板竖插简化测试）；P2 验板短路检查的穷替代 = Mac USB 口过流保护（短路则系统弹窗禁用设备，不烧板）；焊点瑕疵 → 手机维修店代修或重打；镊子=眉夹、卡尺=卷尺、尖嘴钳=徒手轻掰。硬门槛提示：上电后的电压确认与后续异常排查没有万用表就是盲人模式，故此一件不建议省。

---

## 附录 C：图纸交付清单（v2.0 · 2026-10-02 侧磁改版后）

### 现行版（[../02-结构图纸/](../02-结构图纸/README.md)，旧版 29 文件已删除）

| 图纸 | 文件 | 状态 | 送往 |
|---|---|---|---|
| 厚板盲孔板 | `thickplate-v3.scad`（part=plate）+ `export-thickplate.stl` | ✅ 源码 v3.1 侧磁版；板体导出件沿用 | 亚克力定制（CNC/激光+铣盲孔） |
| 键帽块 | `thickplate-v3.scad`（part=block，`-D key_wu=…`） | ✅ v3.1 侧磁版；**导出件待 OpenSCAD 重导** | 光固化代打（先 5 帽试产） |
| 试装板 | `thickplate-v3.scad`（part=test_plate） | ✅ 3 孔位（2×1u+1×2u） | P0′/P3 随打印单出件 |
| 底壳 | `chassis-v3.1.scad` + `export-chassis-v3.1.stl` | ✅ 几何未变（层高已按 v5.0 复核） | 3D 打印（黑树脂/PLA） |
| PCB 摆件坐标 | `pcb-hall-positions.csv` | ✅ **v5.0**：67 霍尔=每键左侧磁铁正下方，邻键磁距校验过 | 立创EDA 摆件 |
| 装配/磁路规范 | `README.md`（v5.0） | ✅ 坐标系/极性/装配顺序/P0′ 闸门 | 自用 + 打印店 |

> OpenSCAD 环境：brew 的包被 Gatekeeper 禁用；实测可用 = 官网开发快照 arm64（files.openscad.org/snapshots/），CLI 路径 `OpenSCAD.app/Contents/MacOS/OpenSCAD`，重导出：`"$SCAD" -o export-block-1u.stl -D 'part="block"' thickplate-v3.scad`。**当前本机未装，键帽块/试装板导出件待补。**

### 待产出（P2 阶段，唯一缺口）

| 图纸 | 产出方式 | 工时 |
|---|---|---|
| PCB 原理图 + Layout | 立创EDA 照 §4 接线表画；或 fork oshwhub 磁轴项目改三处（板框/CSV 坐标/主控段） | 半天原理图 + 1-2 晚 Layout |
| 键位页坐标映射脚本 | HTML 键位块坐标由 CSV × 屏物理尺寸换算，与 `keymap.h` 同源生成 | 1 小时（可由我直接生成） |

> 结论：**结构件图纸已闭环（源码+导出件+验证数据齐）；整机唯一待画图纸只剩 PCB 本身**，其数据源（坐标 CSV + 接线表 §4.2 + keep-out 规范）已全部就位。
