bty1987/KeyCore/01-方案/竞品拆解-FluxKeyboard.md

> ⚠️ **方案演进存档**：本文记录 2026-10-02 的方案决策过程。现行定稿见 `07-PCB/output/设计说明-KeyCore总装-20261007.md`（层叠/分区/引脚）与 `07-PCB/output/画线总结-过程与经验-20261008.md`。

# 竞品拆解 · Flux Keyboard（视频学习笔记）

> 来源：B站 BV1ka4y13774（YouTube 精选字幕组搬运，原片 3'10"，Flux 官方宣传片）
> 参考：Kickstarter 众筹爆款，售价 $450（≈¥3,200+）；原视频 youtu.be/N7OVagiblPo
> 本笔记用途：对照 KeyCore v1.6 方案，吸收其成熟做法，明确我们不抄什么。
> 日期：2026-10-02

## 一句话结论

**Flux 的护城河不在硬件，在显示层软件。** 硬件堆叠（屏上浮透明帽）与 KeyCore 基本同构，
真正值钱的是三件软件事：①按前台 App 自动切换键位画像 ②壁纸/键位分层渲染 ③打字联动动效。
KeyCore 显示层目前只有静态 keymap.html，这三件事是 v1 软件路线的主攻方向。

## 视频时间轴要点

| 时间 | 画面 | 学到什么 |
|---|---|---|
| 0:00-0:14 | 黑场→键盘点亮→墨水泼溅主题动画随打字扩散 | **开场 20 秒全是主题切换动效，不是打字**。"换壁纸=换皮肤"是第一卖点 |
| 0:15-0:18 | 修图 App 画像：Q=Cut W=Close E=Merge R=Rulers T=Transform…；6/7/8/9 键显示红黄绿色块 | 每键**大图标+小字动作标签**双层排版；连色块都画到键位格里 |
| 0:18-0:22 | 视频剪辑画像：B=Blade 剪刀刀片、时间线操作 | 专业软件快捷键是核心用户（剪辑/修图/音乐人） |
| 0:23-0:32 | 日语假名/韩文/阿拉伯/希伯来/俄语皮肤轮播 | **一套硬件吃下所有语言布局**——屏显字的天赋技能 |
| 0:46-0:56 | 文氏图：TACTILE(机械手感) + ADAPTIVE(触屏可变) = FLUX | 一句话定位公式，值得抄话术结构 |
| 0:57-1:02 | Ableton/FCP/Premiere/AE 画像逐个切换，空格键显示 ▶/⏹ 走带键 | **前台 App 检测→自动推画像**，全程无手动操作 |
| 1:04-1:09 | F 键排变 App 启动器（相机/耳机/视频/文档图标） | F 排复用为上下文切换器（v2 可选） |
| 1:10-1:16 | 顶部条显示 CPU/GPU 曲线 + 天气 22°C | 屏幕非键区（动效区）放系统级小组件——KeyCore 大时钟同思路 ✓ |
| 1:13-1:16 | 终端风格橙色主题，屏上滚动宏绑定代码清单 | 极客向皮肤=显示宏映射，调试界面也能当皮肤卖 |
| 1:17-1:22 | WPM 计数 + 火箭随打字速度加速；打字烟花雨 | **打字联动动效**：零硬件成本，演示视频的核心素材 |
| 1:24-1:29 | USB-C 插笔记本 / USB-A 插台式机 | "所有计算在内置处理器完成→兼容任何电脑、免驱动"是重要卖点 |
| 1:30-1:36 | 整块透明磁悬浮按键组特写；"完全自定义驱动+快速触发游戏模式" | 磁轴→可调触发行程/RT，与 KeyCore HAL49E 路线互证 ✓ |
| 1:37-1:42 | FPS 游戏画像：武器图标、红绿方向箭头 | 游戏画像把"信息显示"用到极致（弹药/方向） |
| 1:43-1:56 | 掀起整块按键框架，2:15s 计时换装 TACTILE→LINEAR 键盘层，屏放 F1 进站动画 | **磁吸键帽组=可整块快换**（打字帽/游戏帽两套）。KeyCore 磁悬浮结构天然支持，记入 v2 |
| 1:57-2:17 | 顶部模块条：单旋钮(音量/缩放/笔刷)、三旋钮(曝光/色温/色调)、三键模块(媒体键+专辑封面小屏/Zoom 静音/跑酷小游戏) | 最多 4 模块。屏幕在旋钮下方画刻度弧——**显示永远镜像物理件**，与 KeyCore"显示=实体"原则一致 ✓ |
| 2:32-2:40 | 全铝外壳，双手端起展示 | 全铝=高级感来源。KeyCore v1 亚克力/3D 壳≈¥320，定型后再考虑 |
| 2:47-3:00 | 白紫合成波日落、海上日出等主题收尾 | 主题库存是持续运营资产，每个主题都是一次传播素材 |

## 验证了 KeyCore 已有的决策

1. **结构同构**：屏上浮整块透明磁悬浮键帽组——Flux 实证该堆叠可量产可众筹。
2. **磁轴选型**：Flux 主打"完全自定义驱动+快速触发"，KeyCore HAL49E 线性霍尔 + 100~140Hz 采样路线正确；P5 的 DMA 1kHz 升级就是它的"快速触发游戏模式"。
3. **字由屏显、帽不刻字**：Flux 同做法，且语言皮肤（中日韩阿希俄）是屏显独有的免费卖点。
4. **动效区思路**：顶部条/非键区放时钟、系统信息、主题动画——KeyCore"大时钟居中"范式方向一致。
5. **显示镜像实体**：旋钮刻度画在旋钮正下方，无虚拟假按钮——与 v1.5"显示与实体必须一致"原则完全一致。

## 值得抄的（映射到阶段）

| # | 事项 | 落点 | 成本 |
|---|---|---|---|
| 1 | **渲染分层**：壁纸层（图/视频/动效）与键位层（画像）分离，可独立换肤 | `04-显示层/keymap.html` 重构为 layer 结构 | 纯前端，0 元 |
| 2 | **双层键位排版**：每键大图标/大字 + 底部小字动作名（透明帽=放大镜，字号要大、对比要高） | keymap.html 样式规范 | 0 元 |
| 3 | **画像(Profile)系统**：画像=布局 JSON（键位/图标/宏），内置 打字/FPS/剪辑 3 套起步 | 固件 keymap + 渲染端约定 | 1-2 天 |
| 4 | **前台 App 自动切换**：PC 端小工具（AHK/Python）检测前台窗口→串口/网络推画像；笔记本 HDMI 方案下=切换全屏页 | 配套脚本（P4 联调时做） | 半天 |
| 5 | **打字联动动效**：按键高亮（已有串口联动计划）+ WPM 计数 + 涟漪/烟花 | 渲染端动效库 | 半天 |
| 6 | **演示视频脚本**：开场黑场→点亮→主题泼溅切换→画像轮播→打字动效，前 20 秒不放打字 | P4 完成后拍 | 0 元 |

## 不抄 / 暂缓

- **模块条（旋钮/三键模块）**：涉及第二套 PCB 与结构件，v1 明确不做；但 P2 画板时在盖板/壳体上**不堵死**顶部扩展位即可。
- **整块键帽组快换（打字/游戏两套帽）**：磁悬浮天然支持，等 P3 键帽工艺稳定后再评估，记入 v2。
- **全铝外壳**：定型后单台 ¥1,150 的成本口径下先不上；作为商业版升级项。
- **内置处理器全离线渲染（免驱动兼容任何电脑）**：Flux 的核心卖点，对应 KeyCore 的香橙派 Zero 3 备选路线（§10）。v1 笔记本 HDMI 直连够用；**若将来做产品化，"免驱动"是从玩具到产品的分水岭**，届时香橙派路线转正。

## 补充拆解 · LTT 实测评测（B站官方双语 BV1qnRzBCEbY，10'13"，2026-10-02 观看）

> Linus 拿到的是 Reddit 众筹用户出借的量产机。官方宣传 vs 实测的落差全在这一期，**比官方片更有学习价值**。

### 实测规格（官方页/实测）

| 项目 | 官方 | LTT 实测 |
|---|---|---|
| 屏幕 | 1080P / 300nit / 100% sRGB | **326nit 裸屏，透过键帽后 ≈280nit（衰减 ~14%）**，~170PPI |
| 轴体 | Maglev 磁悬浮，0.1mm 霍尔分辨率，4mm 行程 | 侧面磁铁替代弹簧回弹；线性/段落两种键框 |
| 触发 | 0.4~2.8mm 可调 + 快速触发 | 软件里每键独立可调，RT 开关齐备 |
| 回报率 | 1000Hz / 1-2ms 延迟 | **实测平均 10.1ms（8.5~11.4ms）** |
| 主控 | 四核 ARM SOC + **8GB 板载存储** | 配置/画像/视频背景可存机内，换电脑带走 |
| 供电 | 双头线：USB-A/ C 数据 + 独立 USB-C 供电（建议≥30W） | 还要带 2 个 USB2.0 直通口，功耗不小 |
| 系统 | Win10/11 · macOS 12+ · Linux | Linux 发布即支持（DEB/RPM），安卓/iOS 受限 |
| 价格 | — | **$530 仅键盘本体，模块另购** |

### LTT 暴露的真实短板（KeyCore 的避坑清单）

1. **打字手感是最大差评**：无轴心→键帽左右晃动；**按偏时键帽会歪斜、所需力度明显变大**，"not the most forgiving design"；整体像加长行程的剪刀脚，不如机械轴。→ KeyCore 对策：P3 键帽试产必须加**摇晃量/偏按测试**；我们的颈 4.5mm 穿盖板孔正是横向导向结构，要量化验证它够不够。
2. **亚克力保养是隐藏雷**：官方警告不要碰键框底面（指纹极难清理）、**禁用酒精/化学清洁剂**（亚克力会裂蚀）。→ KeyCore 盖板/键帽同为亚克力+树脂，说明书必须写清，且出厂贴膜。
3. **延迟宣传口径翻车**：宣传 1-2ms，实测 10ms。→ KeyCore 的 100~140Hz 扫描≈7-10ms，**实测口径和 Flux 真实水平相当**；宣传时只说实测数，P5 上 DMA 1kHz 前不谈 1000Hz。
4. **App 自动切换依赖 PC 端软件**：Polymath 不跑就没有前台应用检测，画像虽存机内但不能自动切。→ KeyCore 机会：把"自动切画像"做进香橙派独立渲染路线，实现不依赖 PC 软件的真·免驱动。
5. **软件臃肿**：Polymath 680MB，Linus 吐槽"还记得 600MB 的显卡驱动吗"。→ KeyCore 显示层是 Web 页（keymap.html），天然轻量，这是架构优势。
6. **屏幕亮度按透过率验收**：Flux 标 300nit 是裸屏口径，透过键帽只剩 280。→ KeyCore P1 屏验收应加"透过树脂帽实测亮度"项。
7. **$530 价格是劝退点**：Linus 结论"对特定工作流（剪辑）名副其实，对其他人难以推荐"。→ KeyCore BOM ¥1,150（≈$160）价格带完全错位，这是商业化最大的窗。

### 实拍帧观察（LTT 00:22 键区特写，keymap.html 排版规范依据）

- **双层排版实锤**：字母键主字居中大号，键窗底部另有小字动作标签（达芬奇画像下 O 键="Go to Out"）；F 区小号字靠左上；Print Screen/Insert 长名两行居中。
- **字号分级**：字母键 > 功能键 > 动作标签；白色无衬线高对比，按透过率打折后仍可读（326→280nit）。
- **键帽=透明小盒坐进键框冰格式格子**，帽靠格子壁导向（LTT 抱怨的摇晃来源）；KeyCore 用"颈穿盖板孔"导向，路线不同，P3 试产对比摇晃量。
- **格壁吃掉大量屏显面积且反光明显**；KeyCore 整块盖板打 67 孔的方案视觉更干净，是可做差异点。
- **动态视频壁纸不影响键名可读性**（帽壁遮挡+键名高对比）→ 壁纸层可大胆用视频。

**→ keymap.html 排版规范**：①每键=主字层+底部动作标签层（标签 60~70% 不透明度）②字号三级 ③只把内容画进盖板孔可见区（用 pcb-hall-positions.csv 生成，杜绝手填）④白色主字+轻微暗描边保证透过树脂帽可读。

### LTT 的核心结论（对 KeyCore 最重要的判断）

> **"I don't even care that it's kind of a bad keyboard."**（打字手感平庸，但显示层太酷，他不在乎）

即：**显示层就是产品本身，键盘部分及格即可。** 这验证了 KeyCore 把资源押在显示层/动效区/画像系统的路线——不必为了极致手感拖慢整体进度。同时 Linux 首发即支持、8GB 板载存储、视频背景上传，都是低成本高感知的加分项，可记入 v2。

## 差异化机会（Flux 没做/做得弱的）

1. **价格**：$450 vs KeyCore 单台 BOM ≈¥1,150——若商业化，价格带完全错位竞争。
2. **磁轴可调触发行程**：Flux 宣传了 RT 但视频未演示行程调节界面；KeyCore 线性霍尔有真实行程曲线（P0 已实测 Δ+1023mV），可做**每键独立触发行程设置**并在屏上可视化标定——硬件能力是自己的，界面上放大它。
3. **中文生态**：中文布局/拼音输入法提示/微信系快捷键画像，Flux（海外团队）不会优先做。
