bty1987/KeyCore/06-测试记录/P0-验证报告.md

# P0 单键验证报告 · 2026-09-29 · ✅ PASS

> **⚠ v2.0 部分取代（2026-10-02）**：本报告"磁铁规格锁定 6×3"的结论已被 **v5.0 侧磁方案（4×2 侧壁 ×2/键，霍尔左磁正下方）**取代；
> 但**隔屏检测可行、极性双向响应、邻域噪声 ±4mV** 三项物理结论仍然有效（v5.0 直接复用）。
> 4×2 侧磁的信号/回弹/串扰由 **P0′**（01-方案 §3）重新实测裁决。原始数据保留作证据链。

## 判定
Δ 峰值 **+1023mV**（验收线 80mV 的 **12.8 倍**）→ **磁路方案实锤成立，磁铁规格锁定 6×3**

## 实测环境
- 板：ESP32-S3 N16R8（嘉顺）· 固件 P0 v1（GPIO4/49E，77Hz 采样）
- 霍尔：49E TO-92S 直插长脚（佳芯维），面包板直立插装
- 磁铁：N52 6×3（空气直测，无屏/无亚克力——比真实工况更苛刻条件下裕量反而更大）
- 基线：1663mV，噪声 ±4mV（标准差 1.0，8 秒零漂移）

## 关键数据
| 项目 | 数值 |
|---|---|
| 磁铁进场信号爬升 | 21s→30s：+16 → +179 → **+973mV** |
| 最近点峰值 | **+1023mV** |
| 极性翻转测试 | 双向响应确认（N 正向 / S 反向），信号负向=磁铁 S 面朝霍尔 |
| 邻域噪声本底 | ±4mV（意味着 67 键互扰可忽略） |

## 排障记录（后来者参考）
1. 按压致霍尔腿在面包板松脱 → 掉回悬空值 822mV（工作零点 1554~1663 可区分两种状态）
2. RST 针（左列第3根）残留杜邦线 → 固件不起、串口哑——左列只允许 3V3/4/GND 三根线
3. USB 掉线 → 重新枚举即恢复（原生口免驱）
4. 直立插装时磁铁须**水平凑近印字面**（垂直下压磁场与感应轴平行≈无信号）

## 原始数据
- `P0-60s接近曲线-raw数据.log`（本轮主证据，峰值段 27~30s）
- `P0-极性翻转测试-raw数据.log`
- `P0-霍尔接线基线-raw数据.log`
