bty1987/KeyCore/07-PCB/output/设计说明-KeyCore总装-20261007.md

# KeyCore 磁轴键盘 — 总装设计说明

- 版本：v1.0（2026-10-07）
- 工程：KeyCore-v43b-3c（EDA 净板，111 元件，全部绑定立创 C 号）
- 状态：机械布局定稿 / BOM 闭环 / 待画线

---

## 一、设计定位

**键盘功能 + 显示屏 + 预留扩展，三合一的磁轴键盘设备：**

1. **键盘功能**：67 键磁轴阵列（6 行 × 65% 配列，键距 19.05mm 标准键距），霍尔感应 + 磁轴键帽，全键无冲可编程；
2. **显示屏**：13.3" 屏幕（显示区 293.7×165.2）覆盖键位区上方，屏显键帽/状态信息，**屏幕显示的同时**键盘正常工作；
3. **预留扩展**：M1~M6 宏键 ×6、IO38 LED 软件可控、IO21 温度探头（1-Wire）、UART 调试口、空余 GPIO（IO3/IO38~IO42），为后续功能扩展预留硬件接口。

## 二、整机层叠结构（自上而下）

| 层 | 厚度 mm | 外廓 mm | 说明 |
|---|---|---|---|
| 键帽块 ×67 | 7.5 | 每块 =键宽×19.05−2.0 | 悬浮于厚板通孔内（真行程），顶露板面 1~1.5mm |
| **亚克力厚板** | **9.0** | **300.2 × 192** | 透明亚克力，67 通孔打穿（孔随键宽 17.6~117.4 R2）+ 水平磁道 73 条 |
| 悬浮气隙 | 4.0 | — | 键帽行程 3 + 安全 1 |
| **屏幕** | **2.5** | **300.2 × 187.4（外围）** | 显示区 293.7 × 165.2（实测），正面朝上 |
| 空气隙 | 2.6 | — | 屏玻璃下限高 2.6（ESP32 2.4 ✓） |
| **PCB** | **1.6** | **300 × 192** | 霍尔 67（感应面朝上）+ 全部元件 |
| 底壳 | 3.0（外壁总高 22.7） | 308.2 × 200 | 壁厚 4，包络全部层叠 |

### 三层对齐规则（用户定稿）

- **底部齐平**：屏幕外围 / 亚克力 / PCB 底边同线（y=192）；
- **左右居中**：PCB 300 vs 屏/亚克力 300.2，每侧差 0.1mm；
- 屏幕上缘超出 PCB 顶边 7.7mm（该区立体上与 USB-C 错开，不挡插拔）。

## 三、功能分区（板面 y 坐标，自顶边起算）

| 分区 | y 范围 mm | 内容 |
|---|---|---|
| 屏幕信息条 | 23.55 ~ 59.5（约 36mm） | 屏幕显示区上部：状态/信息显示（M1 键排之上、键位区之外）|
| **键位区** | 59.5 ~ 154.8 | 67 磁轴键位（6 行：6/14/14/13/12/8），19.05 键距，显示区全覆盖 ✓ |
| 硬件带 | 155 ~ 172 | SW1(BOOT)/SW2(EN)、J2 温度探头座、J3 UART、LED1、USB-C（板顶 y≈0）|
| 底部余量 | 172 ~ 192 | 预留（键帽下缘 163.3 之外 28.7mm）|

### 功能引脚分配（ESP32-S3-WROOM-1-N4R8，41 脚全对照 ✓）

| 功能 | 引脚 | 状态 |
|---|---|---|
| USB 差分 | 13/14 = IO19/20 | USB_DN/DP ✓ |
| BOOT | 27 = IO0 | 按键 ✓ |
| EN | 3 | 复位 ✓ |
| **LED（软件可控）** | **31 = IO38** | 本次修正：从 GND 脚挪出 ✓ |
| **温度探头 1-Wire** | **23 = IO21** | J2 探头座 + 4.7K 上拉 ✓ |
| UART 调试 | 10/11 = IO17/18 | J3（UART1）✓ |
| **PSRAM 保留脚 28~30 = IO35/36/37** | 空置 | N4R8 强制留空 ✓（R8 内证）|
| 空余 GPIO | IO3、IO38~42（除 IO38 LED） | 预留扩展 ✓ |

## 四、BOM（18 项，全部立创可下单）

| # | C 号 | 器件 | 数量 | 位号 |
|---|---|---|---|---|
| 1 | C7420984 | HAL49ESO 线性霍尔（1=VDD/2=GND/3=OUT 已核对） | 67 | H01~H67 |
| 2 | C2943297 | 74HC4051 SOP-16 | 9 | U101~U109 |
| 3 | C2913200 | ESP32-S3-WROOM-1-**N4R8** | 1 | U1 |
| 4 | C6186 | AMS1117-3.3 SOT-223（1=GND/2=3V3+tab/3=VBUS） | 1 | U2 |
| 5 | C165948 | TYPE-C-31-M-12 卧贴 16P（口朝板边 ✓） | 1 | J1 |
| 6 | C2937625 | PZ254V-11-03P 1×3 2.54 | 1 | J2（DS18B20 探头座）|
| 7 | C41425294 | PZ254V-11-04P-RD 1×4 2.54 | 1 | J3（UART）|
| 8 | C318884 | TS-1187A-B-A-B 轻触开关（H1.5 矮体×2） | 2 | SW1/SW2 |
| 9 | C45783 | 22uF 0805 25V | 2 | C_V1/C_V2 |
| 10 | C2932476 | 10uF 0805 50V | 3 | C_IN1/C_EN/C_M1 |
| 11 | C1711 | 0.1uF 0805 50V | 2 | C_IN2/C_M2 |
| 12 | C17414 | 10K 0805 1% | 10 | R_EN/R_E1~E9 |
| 13 | C17673 | 4.7K 0805 1% | 1 | R_DQ |
| 14 | C27834 | 5.1K 0805 1% | 2 | R_CC1/R_CC2 |
| 15 | C17513 | 1K 0805 1% | 1 | R_LED |
| 16 | C54770670 | 红光 LED 0805（IO38 软件可控） | 1 | LED1 |

**作废编号（禁止采购）**：~~C2286~~（0603 装不上 0805）、~~C39794~~（未验证）、~~C52092029~~（4.5mm 装不上 5.1 封装）、~~C9900001716~~（不可下单）、~~C347222~~（被 C6186 取代）、~~安装孔配 JST~~（误配不采购）。

## 五、已验证与已修正（本阶段）

| 类别 | 内容 |
|---|---|
| **封装修正** | SOIC 焊盘方向（9 颗）、USB-C 口朝向（180° 修正）、按键 C318884 重绑、U1 官方封装、U2 官方封装 |
| **引脚核对** | U1 41 脚全对照 ✓（37 对+2 修正）、HAL49ESO 引脚 ✓（用户确认）、U2 ✓、J1 ✓ |
| **网络补全** | pad39 补 GND、LED 挪 IO38、pad38 恢复 GND ✓ |
| **层叠验证** | 高度链 9+4+2.5+2.6+1.6+3 全合规（ESP32 2.4 < 玻璃下限 2.6 ✓；6mm 矮排针 10.6 < 托圈 13.7 ✓）|
| **布线** | 未开始（本阶段净板交付）|

## 六、遗留待办

1. **画线**：键位表/元件/机械全闭环，可开始；
2. **厚板打穿版订购图**：按 V4（300.2×192×9 + 67 打穿孔 + 磁道 73）重出，替代作废的 v5.5/v5.6 盲孔版；
3. **键帽块加长 11 设计**（悬浮于通孔，P3）；
4. **底壳 chassis scad 同步**：内腔/托圈按新亚克力 300.2×192 核对；
5. **屏幕排线出线方向**：实摆确认；
6. **固件**：N4R8 开 octal PSRAM；IO38 LED 控制；IO21 温度读取；M1~M6 宏定义。

---

*坐标基准：PCB 左上角 (0,0)，x 向右 y 向下，单位 mm。安装孔中心：(6,7)(150,7)(294,7)(6,166)(150,166)(294,166)。*
