bty1987/KeyCore/00-文档/项目禁词与铁律.md

# 项目禁词与铁律

## 禁词（永久生效）

- **孔底磁铁**：永久废弃，任何文档、图纸、对话中不得再出现此方案
- **底面中心感应**：永久废弃
- **盖板穿脖子**：永久废弃（v1.6 前的方案）

## 当前唯一方案

**侧面磁铁**——磁铁嵌在键孔侧壁的筋内，从上方透过透明亚克力可见，与 Flux 同款。

## 违规处理

任何新生成文件中出现禁词方案 = 立即回退，不得进入生产。
