bty1987/KeyCore/05-效果图/v3-厚板顶面观.png

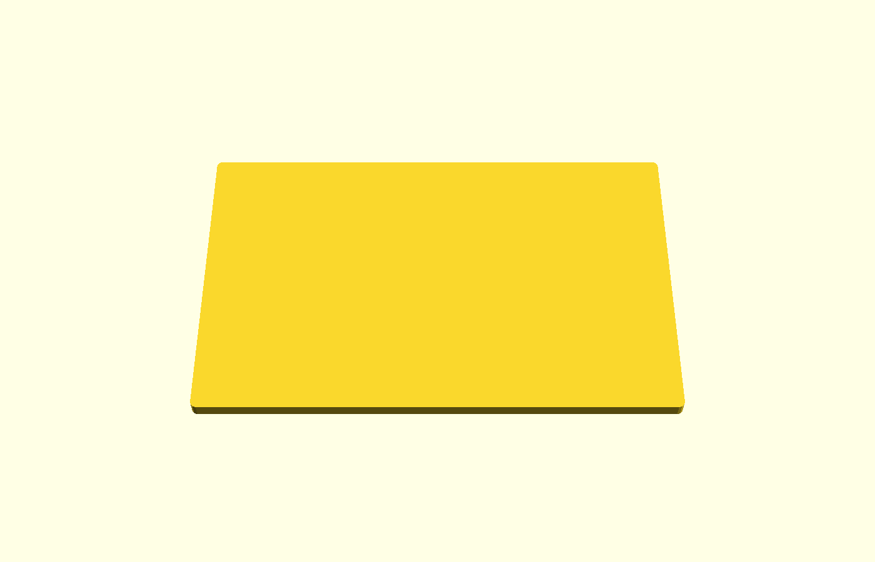
05-效果图/v3-厚板顶面观.png
