bty1987/KeyCore/05-效果图/v3-底壳渲染.png

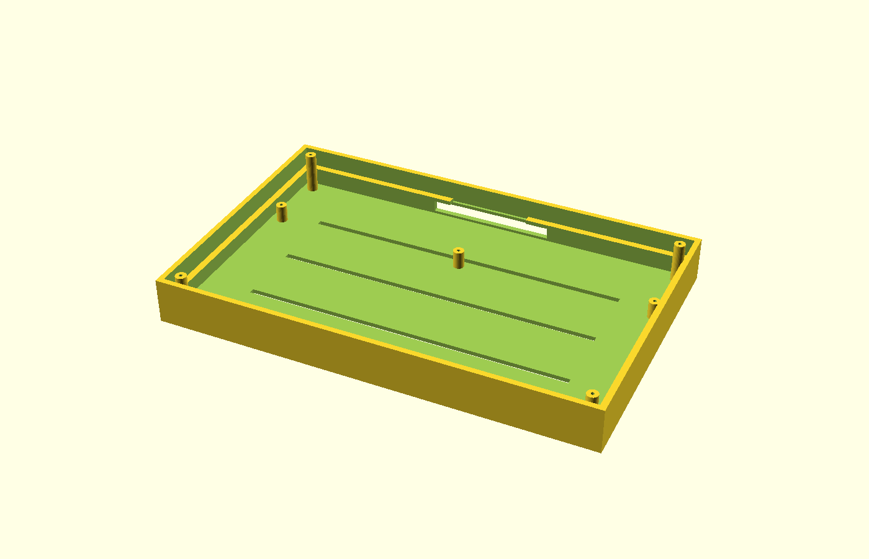
05-效果图/v3-底壳渲染.png
