bty1987/KeyCore/05-效果图/厚板订购图-v5.6.png

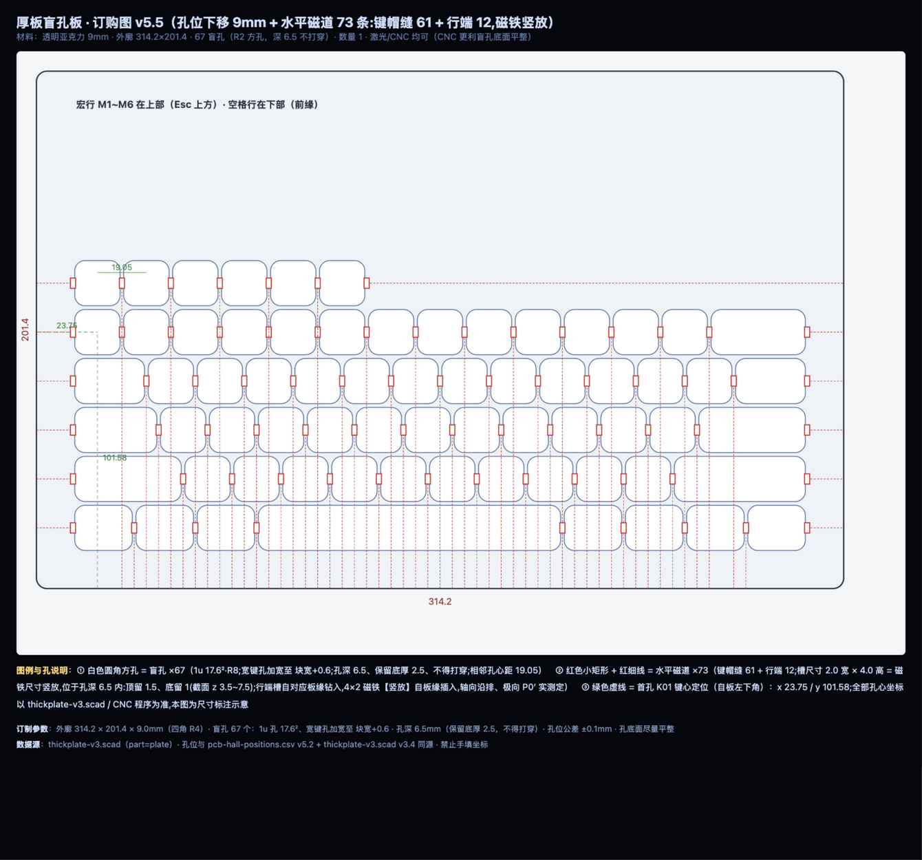
05-效果图/厚板订购图-v5.6.png
