bty1987/KeyCore/05-效果图/总装基准图-v1.0.png

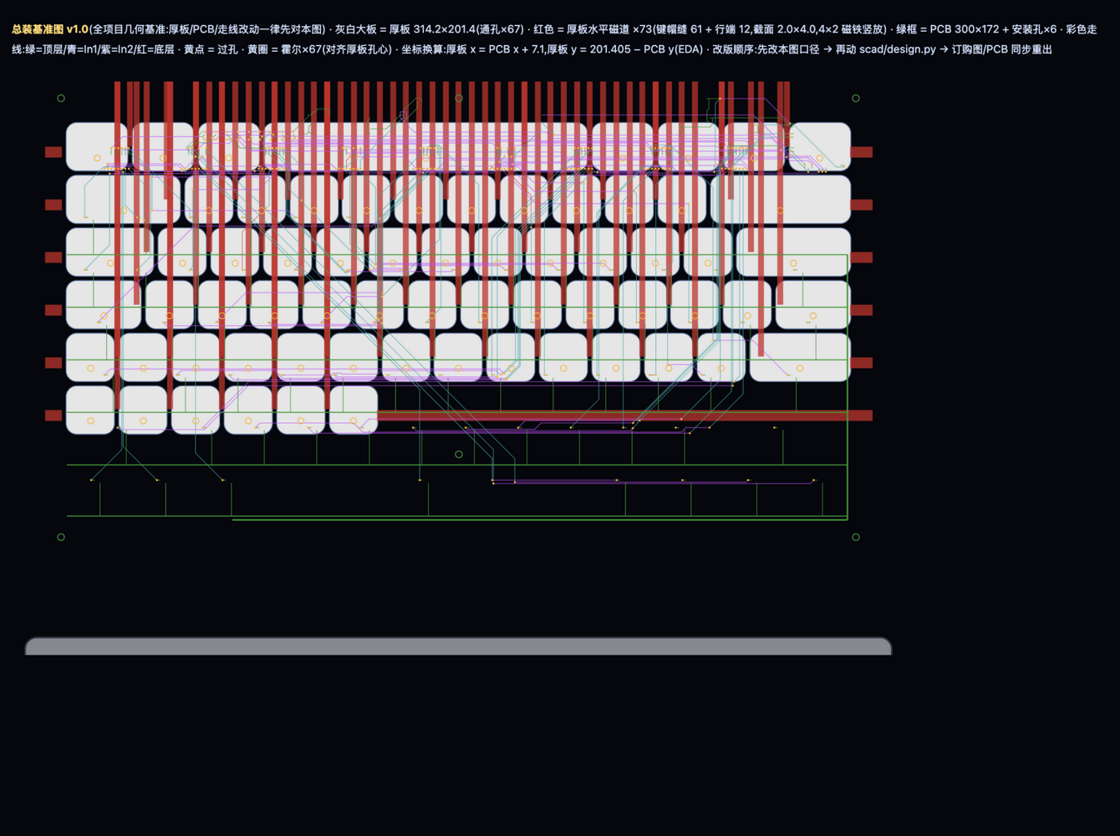
05-效果图/总装基准图-v1.0.png
