bty1987/KeyCore/05-效果图/磁路解释图-v5.4.png

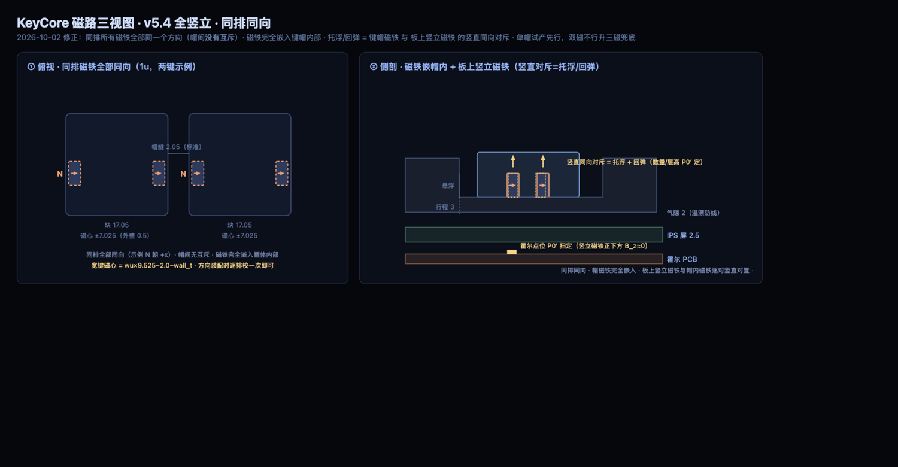
05-效果图/磁路解释图-v5.4.png
