bty1987/KeyCore/05-效果图/键帽块v5-全竖立版.png

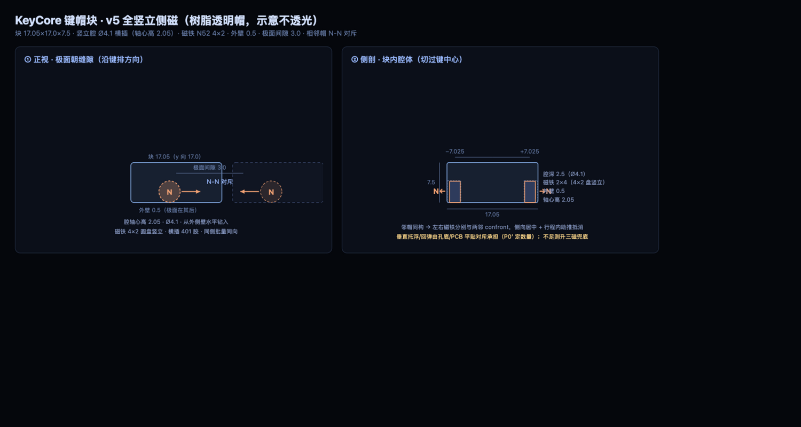
05-效果图/键帽块v5-全竖立版.png
