bty1987/KeyCore/07-PCB/output/preview_bot.png

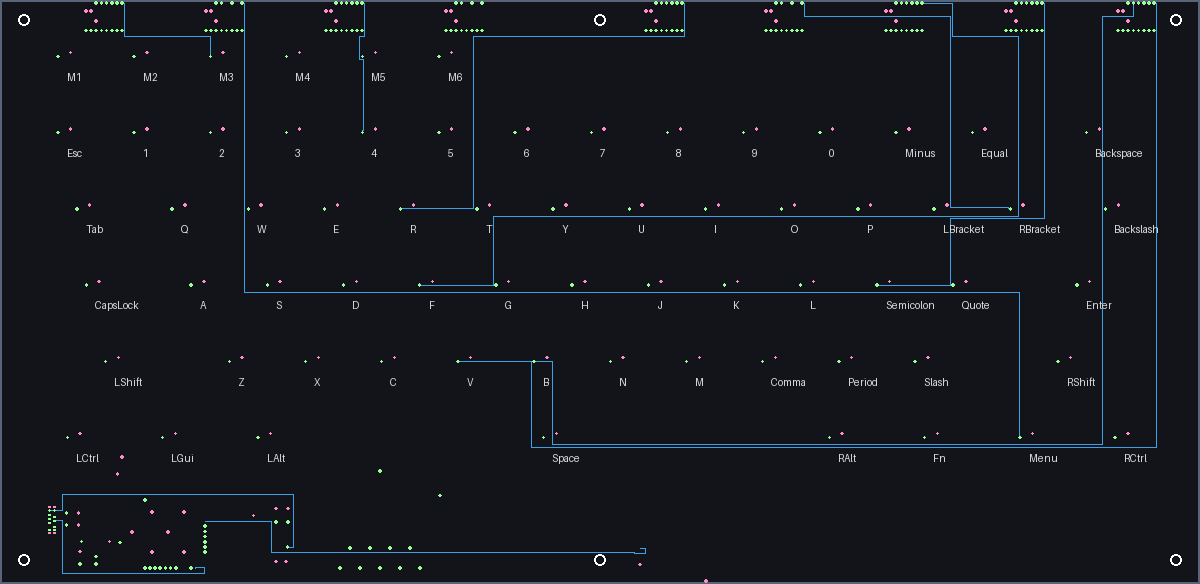
07-PCB/output/preview_bot.png
