bty1987/KeyCore/07-PCB/output/preview_top.png

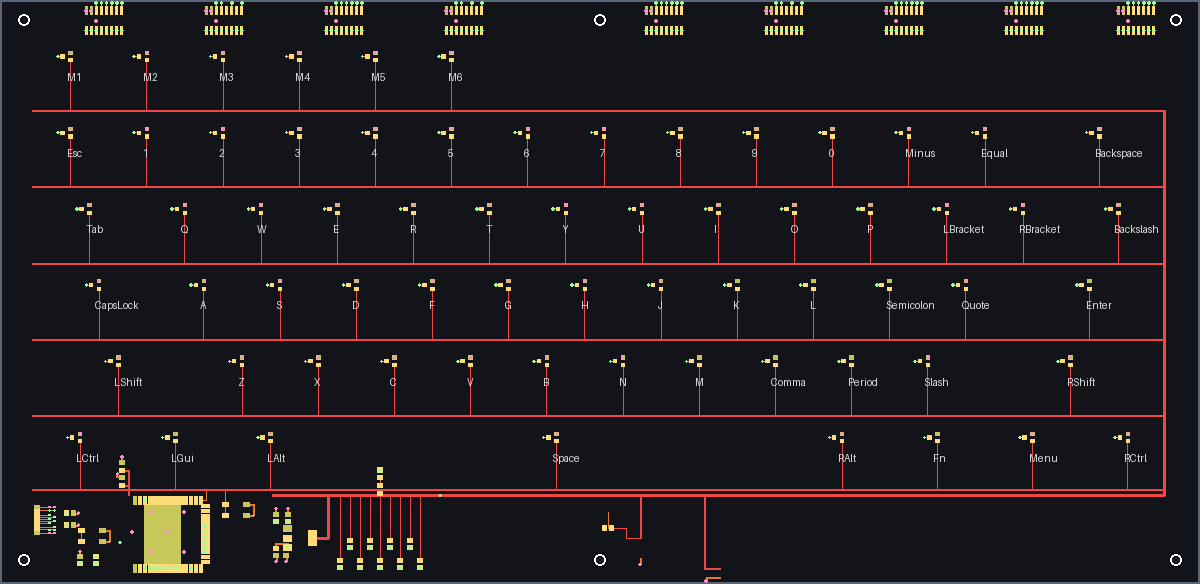
07-PCB/output/preview_top.png
