bty1987/KeyCore/07-PCB/output/厚板订购图-V6-预览.png

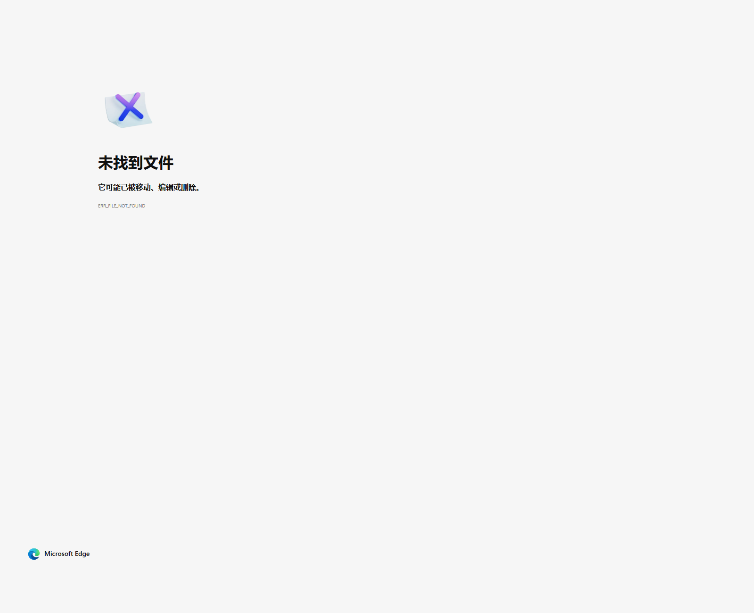
07-PCB/output/厚板订购图-V6-预览.png
