bty1987/KeyCore/07-PCB/output/当前布局-192mm-确认.png

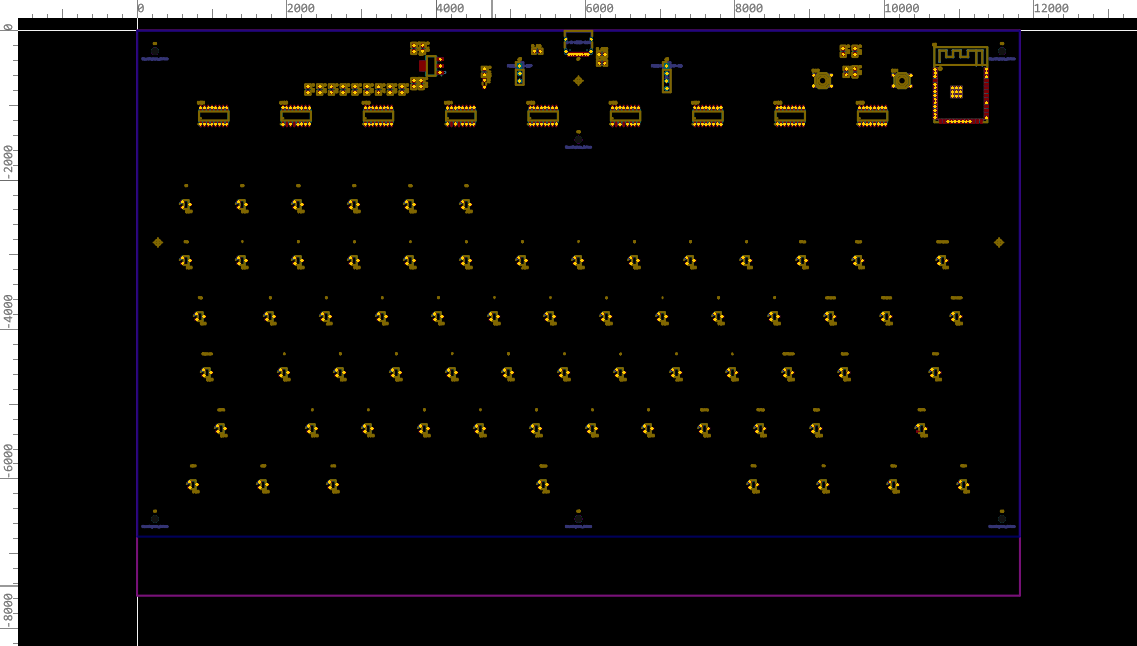
07-PCB/output/当前布局-192mm-确认.png
