bty1987/KeyCore/07-PCB/output/总装分层对比-预览.png

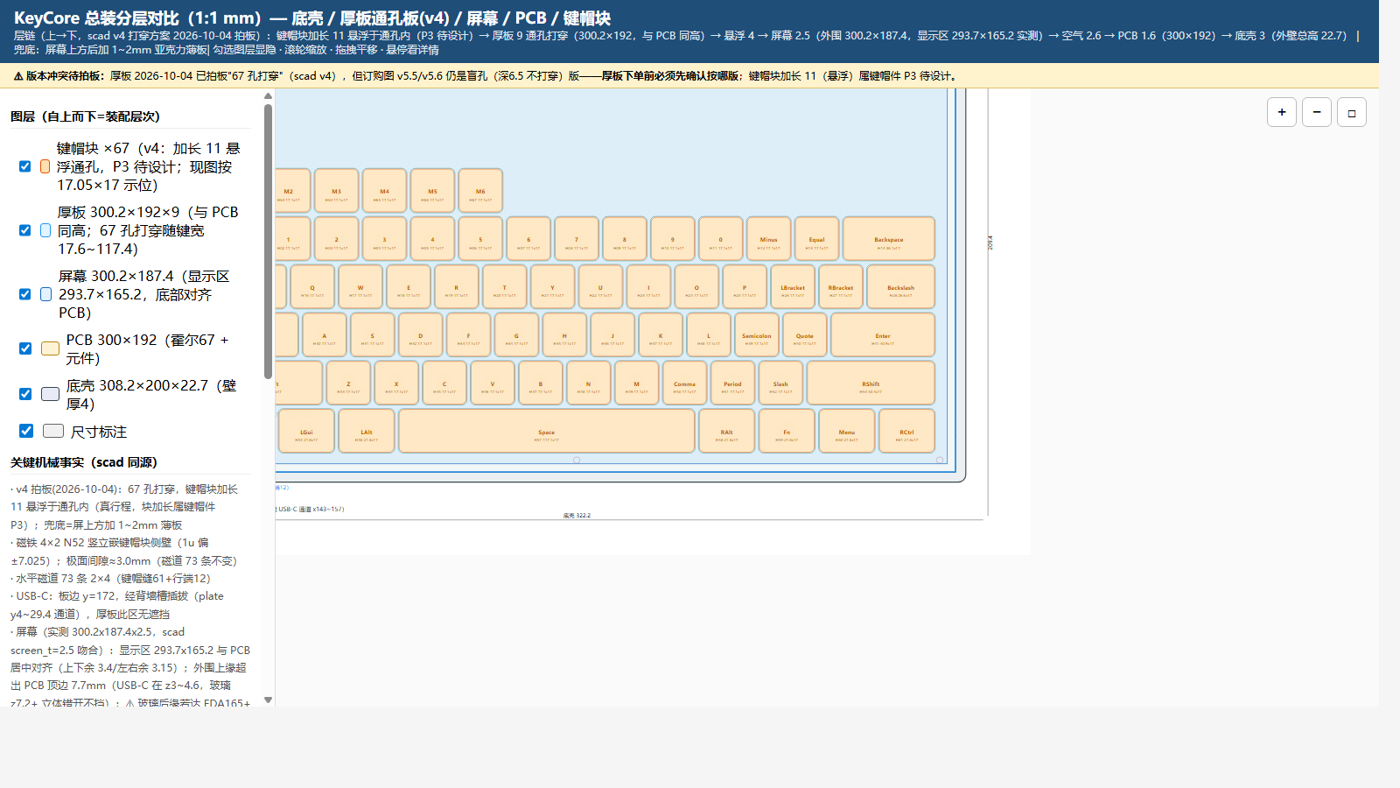
07-PCB/output/总装分层对比-预览.png
