bty1987/KeyCore/docs/images/acrylic-plate-bottom-pockets.png

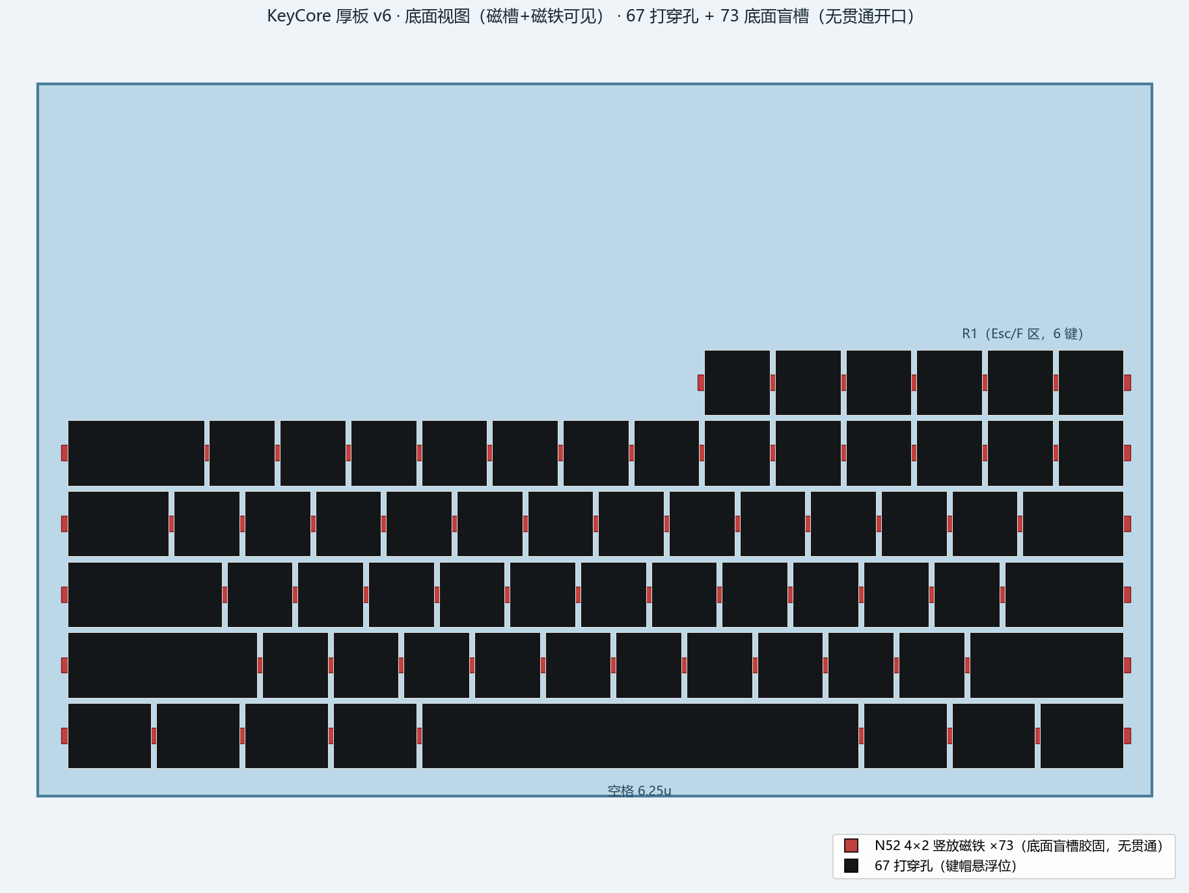
docs/images/acrylic-plate-bottom-pockets.png
