bty1987/KeyCore/docs/images/acrylic-plate-layout.png

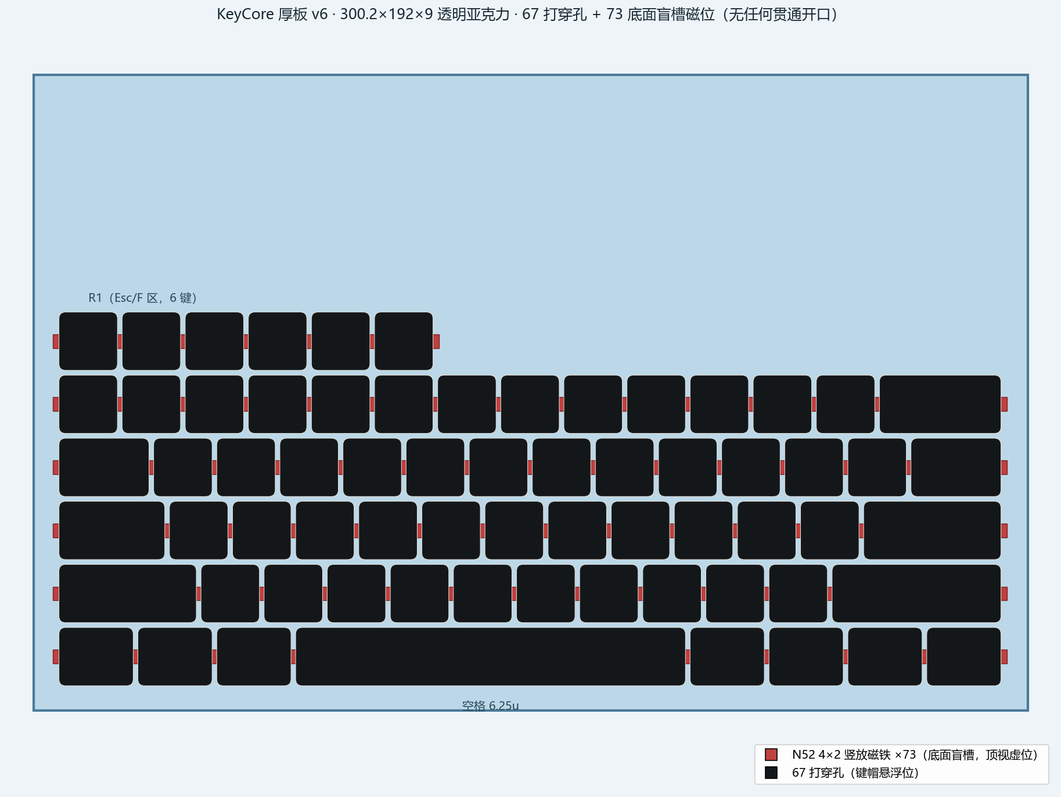
docs/images/acrylic-plate-layout.png
