bty1987/KeyCore/docs/images/acrylic-plate-section.png

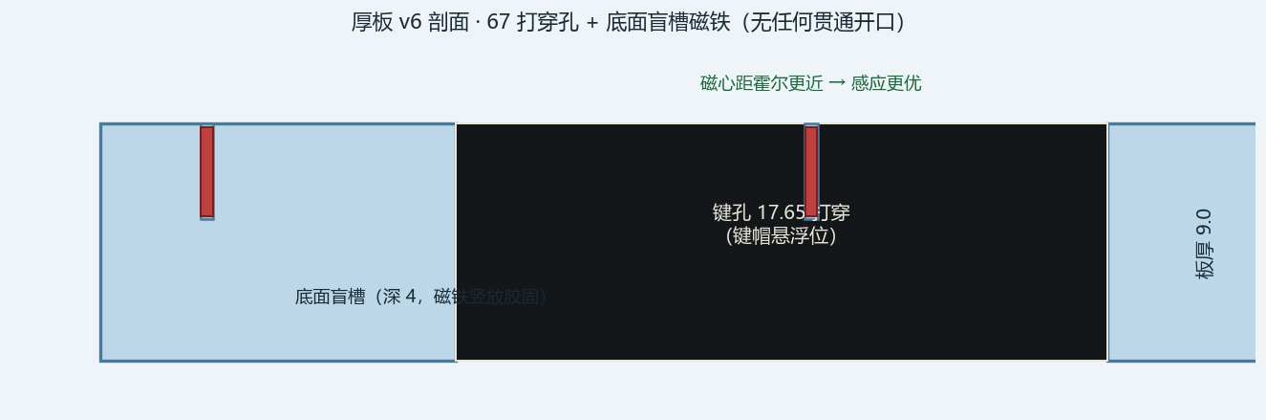
docs/images/acrylic-plate-section.png
