bty1987/KeyCore/docs/images/keycap-front.png

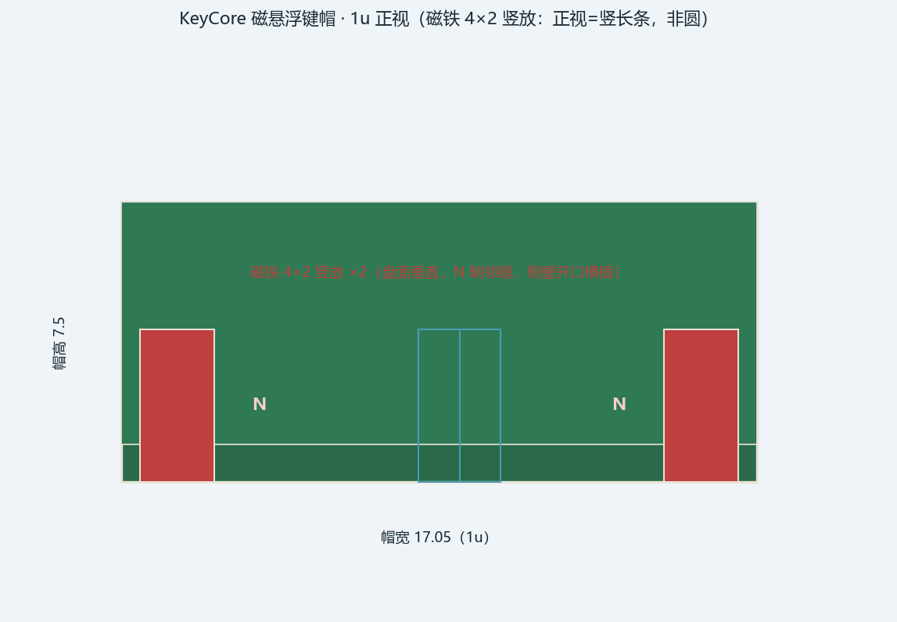
docs/images/keycap-front.png
