bty1987/KeyCore/docs/images/keycap-top.png

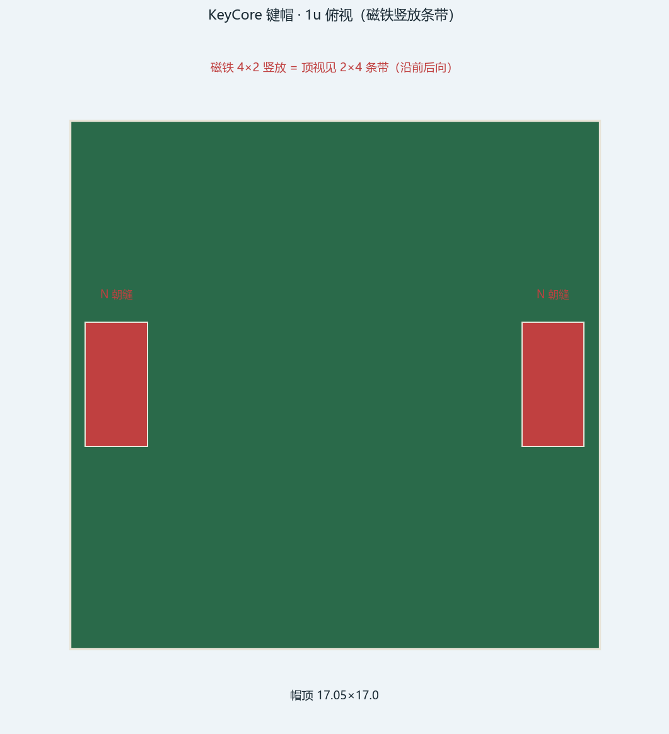
docs/images/keycap-top.png
