bty1987/KeyCore/docs/images/pcb-5c-bottom.png

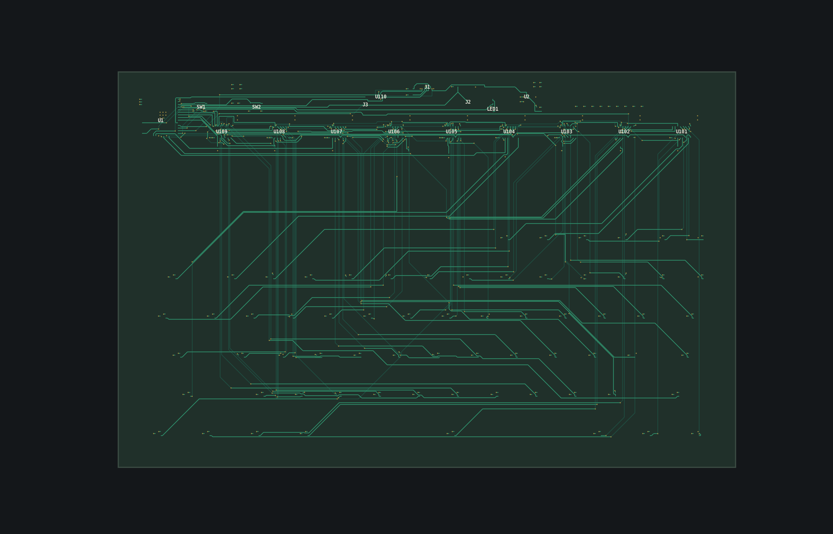
docs/images/pcb-5c-bottom.png
