bty1987/KeyCore/docs/images/pcb-5c-top.png

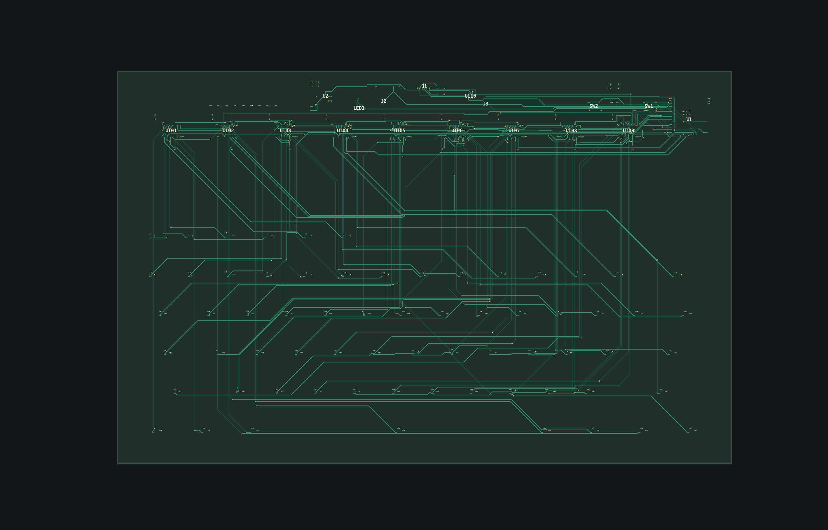
docs/images/pcb-5c-top.png
