bty1987/KeyCore/docs/images/plan-panel.png

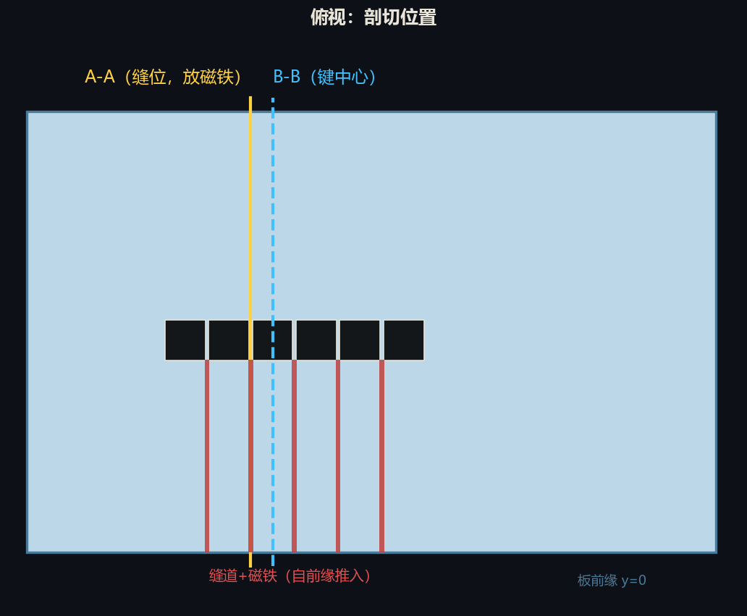
docs/images/plan-panel.png
