bty1987/KeyCore/07-PCB/output/下单清单-最终版-20261007.md

# KeyCore 下单清单（最终版）— 2026-10-07

> 本清单是唯一有效版本。此前对话中报过但被推翻的 C 号见文末"作废清单"，**不要下单**。

## 一、PCB 打样

- KeyCore-v43b-3c 导出 Gerber 后下单（双层板 300×172mm）
- ⚠️ 下单前必须完成：机械三要素确认（屏幕实测尺寸/亚克力/键位）——屏幕遮挡关系未定，板子可能要改

## 二、元件采购清单（立创商城，共 18 项 / 111 个位号）

| # | C 号 | 型号 | 数量 | 位号 | 用途 | 单价参考 |
|---|---|---|---|---|---|---|
| 1 | **C7420984** | HAL49ESO 线性霍尔 | 67（建议 70 含备件） | H01~H67 | 磁轴键位感应 | ¥0.56 |
| 2 | **C2943297** | 74HC4051 SOP-16 | 9 | U101~U109 | 键位扫描多路器 | ¥0.5~1 |
| 3 | **C2913200** | ESP32-S3-WROOM-1-**N4R8** | 1 | U1 | 主控（4MB+8MB PSRAM，固件开 octal PSRAM） | ¥25.32 |
| 4 | **C6186** | AMS1117-3.3 SOT-223 | 1 | U2 | 3.3V LDO | ¥0.3 |
| 5 | **C165948** | TYPE-C-31-M-12 卧贴 16P（韩国韩荣） | 1 | J1 | USB-C 母座（口朝板边） | ¥1.05 |
| 6 | **C2937625** | PZ254V-11-03P 1×3 2.54 直插 | 1 | J2 | DS18B20 探头座 | ¥0.1~0.3 |
| 7 | **C41425294** | PZ254V-11-04P-RD 1×4 2.54 直插 | 1 | J3 | UART 调试口 | ¥0.1~0.3 |
| 8 | **C318884** | TS-1187A-B-A-B 轻触开关（**H1.5 矮体**） | 2 | SW1(BOOT)、SW2(EN) | 按键（屏幕下方需矮体） | ¥0.1~0.3 |
| 9 | **C45783** | 22uF 0805 25V X5R 三星 | 2 | C_V1,C_V2 | ⚠️ 0805 偏压降额大，若纹波要求高改 1210 | ¥1.35 |
| 10 | **C2932476** | 10uF 0805 50V X5R 三星 | 3 | C_IN1,C_EN,C_M1 | | ¥0.89 |
| 11 | **C1711** | 0.1uF 0805 50V 三星 | 2 | C_IN2,C_M2 | | ¥0.09 |
| 12 | **C27834** | 5.1K 0805 1% 厚声 | 2 | R_CC1,R_CC2 | USB CC 下拉（1% 必要） | ¥0.03 |
| 13 | **C17414** | 10K 0805 1% 厚声 | 10 | R_EN,R_E1~R_E9 | EN 上拉 | ¥0.02 |
| 14 | **C17673** | 4.7K 0805 1% 厚声 | 1 | R_DQ | DS18B20 1-Wire 上拉 | ¥0.03 |
| 15 | **C17513** | 1K 0805 1% 厚声 | 1 | R_LED | LED 限流 | ¥0.02 |
| 16 | **C54770670** | 红光 LED 0805（亿晶源，Vf1.8-2.4V） | 1 | LED1 | 电源指示（IO38 控制闪烁可行） | ¥0.1~0.5 |

小计约 **¥150**（含 MOQ 起订量放大，实际多数料有大量库存）

## 二·5、厚板（透明亚克力，用户拍板 V4 打穿方案 2026-10-04）✅ 订购图已出

- **订购图**：`07-PCB/output/厚板订购图-V6-打穿版-20261007.svg`（V6r，2026-10-07）——⚠️ 作废：v5.5/v5.6 盲孔版（深6.5 不打穿）、V6 初版（行位未对齐 EDA）
- **尺寸**：300.2×192×9.0mm（四角 R4），透明亚克力
- **孔**：67 孔**打穿**（孔宽随键宽 wu×19.05−1.4 = 17.65~117.66，孔高 17.6，R2）
- **磁道**：73 条 = 键帽缝道 61（宽 2.0）+ 行端道 12（高 4.0）；剖面高 4.0（z 3~7，板厚 9 内），自空格侧板缘与左右板缘开口、**不穿透**
- **工艺**：**CNC**（边缘开口盲槽激光无法加工）· 公差 ±0.1mm
- **键帽块**：加长 11 悬浮于通孔内——属键帽件 P3 待设计（与厚板分开下单）
- 数据源：**EDA 实测霍尔位 H01~H67（2026-10-07 live，与总装 HTML 零偏差）**，孔心 = 霍尔位（用户拍板：+4 预放偏置弃用，霍尔位即键位）；空格排孔前缘距板边 7.49mm；scad 源 = `02-结构图纸/thickplate-v4.scad`（v3 盲孔版已删）。⚠️ pcb-hall-positions.csv v5.2 的 y/x 列已过时（EDA 键位其后又下移 11.337mm、x −0.127mm），仅键宽列可用

## 三、外购件（非立创或另购）

- **DS18B20 防水探头**（三线：红 3V3/黄 DATA/黑 GND）→ 插 J2 排针
- **屏幕**：已购（型号/尺寸待用户提供 → 出机械最终图）
- **亚克力板 + 外壳**：尺寸待机械核对后定制
- **磁轴键帽**：67 个键位对应的键帽

## 四、⛔ 作废清单（此前对话报过，**禁止下单**）

| 作废 C 号 | 原因 |
|---|---|
| ~~C2286~~（LED） | **0603 封装**，板上焊盘是 0805，装不上 → 改 **C54770670** |
| ~~C39794~~（DS18B20 座） | 库解析失败未验证 → 改 **C2937625**（PZ254V-11-03P） |
| ~~C52092029~~（按键） | 4.5×4.5 体，板上封装 5.1×5.1 **装不上** → 改 **C318884**（H1.5 矮体） |
| ~~C9900001716~~（按键） | 贴片类编号**不可下单** → 改 **C318884** |
| ~~C347222~~（U2 AMS1117） | 友台兼容件可用，但已定 **C6186 原厂**（二选一，推荐 C6186） |
| ~~安装孔配 JST C545754~~ | 配单 AI 误配；安装孔是结构件**不采购** |

## 五、说明

- MOQ：多数阻容起订 20~100 个（单价低，总价影响小）
- 交期：以上全部"现货 4 小时内发货"
- 屏幕已由用户自行购买（尺寸数据待提供 → 机械最终图）
