bty1987/KeyCore/07-PCB/output/打板清单-KeyCore-v43b-3c-20261008.md

# KeyCore 打板清单（2026-10-08 · Gerber 已出）

## 一、PCB 打板

- **Gerber**：`07-PCB/output/gerber_3c/KeyCore-v43b-3c-JLC-Order.zip`（18 文件，嘉立创短名，直接上传）
- **规格**：4 层 · 300×192mm · 板厚 1.6mm · 喷锡 HASL · 阻焊/丝印色任选
- **层数确认**：GTL(Top)/G1(In1=GND 平面)/G2(In2=3V3 平面)/GBL(Bottom) 四铜齐全 ✓
- **数量**：建议 5 片（贴片起订更划算，备用 1-2 片）
- **预估费用**：¥600~900（4 层按面积计价，以下单页实时报价为准）

## 二、SMT 贴片 BOM（嘉立创商城料，16 项 · 单板用量）

| # | C 号 | 器件 | 单板用量 | 备注 |
|---|---|---|---|---|
| 1 | C7420984 | HAL49ESO 霍尔 SOT-23 | 67 | |
| 2 | C2943297 | 74HC4051 SOIC-16 | 9 | |
| 3 | C2913200 | ESP32-S3-WROOM-1-N4R8 | 1 | ¥25.32/片（最贵件） |
| 4 | C6186 | AMS1117-3.3 SOT-223 | 1 | |
| 5 | C165948 | TYPE-C-31-M-12 USB-C | 1 | |
| 6 | C318884 | TS-1187A-B-A-B 轻触按键 | 2 | SW1/SW2 |
| 7 | C45783 | 22uF 0805 | 2 | |
| 8 | C2932476 | 10uF 0805 | 3 | |
| 9 | C1711 | 0.1uF 0805 | 2 | |
| 10 | C17414 | 10K 0805 | 10 | |
| 11 | C27834 | 5.1K 0805 | 2 | USB CC 下拉 |
| 12 | C17513 | 1K 0805 | 1 | |
| 13 | C17673 | 4.7K 0805 | 1 | DS18B20 上拉 |
| 14 | C54770670 | 红光 LED 0805 | 1 | |

**SMT 贴片建议**：全部贴（67 霍尔+9 SOIC 手焊量大易错；USB-C 0.5mm 间距手焊困难）

## 三、自留件（SMT 不做，收板后自装）

| 件 | C 号/来源 | 说明 |
|---|---|---|
| J2 排针 1×3 | C2937625 | DS18B20 探头座（直插） |
| J3 排针 1×4 | C41425294 | UART（直插） |
| DS18B20 防水探头 | 外购 | 三线：红 3V3/黄 DATA/黑 GND |

## 四、费用预估（5 片含贴片，粗估以下单页为准）

| 项 | 预估 |
|---|---|
| PCB（4 层 ×5） | ¥600~900 |
| SMT 工程费 | ~¥399/单 |
| 钢网（如需） | ~¥100 |
| BOM 料费（5 套） | ~¥350（单套 ¥60~80：ESP32 ¥25 + 霍尔 ¥25 + 其余 ¥15） |
| 贴装费 | 按 0.5 元/焊点量级，数百元 |
| 自留件+探头 | ~¥15 |
| **合计** | **约 ¥1900~2400** |

## 五、已知项记录

- USB_DP/DN 等长差 0.8mm：DRC 唯一剩余项，全速 USB 电气无影响，不影响制造 ✓
- GND "No Connection" 类 DRC 报告：引擎连接图幽灵，平面+97 缝合孔几何完好，不影响制造 ✓

## 六、下单路径

1. 嘉立创下单系统 → PCB 加急/常规 → 上传本 zip → 填规格（4 层/300×192/1.6/数量）
2. 同单选"SMT 贴片" → 上传元件位号表（EDA 可导）+ BOM 表（上表 C 号+用量）→ 采购配单确认
3. 到货后自装：J2/J3 排针 + 插 DS18B20 探头
