bty1987/KeyCore/07-PCB/output/BOM采购清单-v43b.md

# KeyCore v43b 主板采购清单(BOM)
# 板子已在嘉立创下单(打样), 元器件需自行采购+焊接
# 生成: 2026-10-05 | 来源: PCB 文档 BOM 导出 | 共 18 项

## 核心器件
| # | 器件 | 型号 | 封装 | 数量 | 立创商城搜索关键词 |
|---|---|---|---|---|---|
| 1 | 主控 | ESP32-S3-WROOM-1-N4 | 模组 | 1 | ESP32-S3-WROOM-1-N4 (C2913201) |
| 2 | 模拟多路复用 | 74HC4051 | SOIC-16 | 9 | 74HC4051 SOIC-16 (贴片, 选东芝或TI) |
| 3 | 霍尔传感器 | HAL49E | SOT-23 | 67 | HAL49E SOT-23 (可替代: 配磁轴键盘专用) |
| 4 | LDO 稳压 | AMS1117-3.3 | SOT-223 | 1 | AMS1117-3.3 |

## 阻容(0805 贴片)
| # | 值 | 位号 | 数量 | 备注 |
|---|-----|---|---|---|
| 5 | 10uF | C_EN, C_IN1, C_M1 | 3 | 0805 X5R/X7R |
| 6 | 0.1uF | C_IN2, C_M2 | 2 | 0805 |
| 7 | 22uF | C_V1, C_V2 | 2 | 0805 |
| 8 | 5.1K | R_CC1, R_CC2 | 2 | USB CC 下拉, 1%精度 |
| 9 | 4.7K | R_DQ | 1 | DS18B20 上拉 |
| 10 | 10K | R_E1~R_E9 | 10 | 4051 EN 上拉(其实只需9个, 备1) |
| 11 | 1K | R_LED | 1 | LED 限流 |

## 其他
| # | 器件 | 型号/规格 | 数量 | 备注 |
|---|---|---|---|---|
| 12 | USB-C 母座 | 16P 短体 | 1 | HRO 型, 立创搜 USB-C 16P |
| 13 | 轻触按键 | TS-1187A | 2 | BOOT + EN |
| 14 | LED | 0805 绿色 | 1 | 电源指示 |
| 15 | DS18B20 | TO-92 | 1 | 温度传感器(J2 接口) |
| 16 | 排针 | 1×3 P2.54 | 1 | J2 (DS18B20) |
| 17 | 排针 | 1×4 P2.54 | 1 | J3 (UART) |
| 18 | 安装孔 | M2.7 | - | PCB 已开孔, 无需器件 |

## ⚠️ 固件映射警示
K53 绑定在 EN_6 组(U106.4 引脚), 固件扫描表必须同步:
K53 → EN_6 使能 + U106 的 X6 通道(pin 2)

## BOM 缺料号说明
PCB 无原理图(KiCad 直导), BOM 无立创料号列。
采购方式: 按上表"立创商城搜索关键词"逐项搜索, 加入购物车。
HAL49E 如缺货, 可用等效单极霍尔(需确认灵敏度与工作电压 3.3V)。
