bty1987/KeyCore/07-PCB/output/PCBA贴片清单-v43b.md

# KeyCore v43b PCBA 贴片清单(最终版)
# 板子已在嘉立创下单(PCB 打样), 接下来在同一个订单里加"SMT 贴片"服务
# 或单独下 PCBA 订单: 嘉立创首页 → PCB/PCBA 下单 → 选"PCBA" → 上传以下文件

## 统计
- 可 SMT 自动贴片: **105 个**(霍尔 67 + 4051 9 + 阻容 22 + LED 1 + LDO 1 + 安装孔 6†)
- 需确认/手焊: **6 个**(ESP32 模组 1 + USB-C 1 + 按键 2 + 排针 2)
- †安装孔是 PCB 通孔非器件, 贴片自动跳过

## BOM 文件(已生成)
- `output/BOM-PCBA-v43b.csv` — 嘉立创 PCBA 格式(Comment/Designator/Footprint/LCSC)
- `output/PickPlace-PCBA-v43b.csv` — 坐标文件(112 元件, 全 TOP 面)

## 元件 → 立创料号对照(下单时逐项匹配)

### 自动匹配(常备料, 系统自动匹配)
| 器件 | 值 | 数量 | 搜索关键词 |
|---|-----|---|---|
| 0805 电容 | 10uF | 3 | 搜 10uF 0805 → 选 CL21A106KOQNNNE (C15850) |
| 0805 电容 | 0.1uF | 2 | 搜 0.1uF 0805 → C1525 |
| 0805 电容 | 22uF | 2 | 搜 22uF 0805 |
| 0805 电阻 | 5.1K | 2 | 搜 5.1K 0805 1% |
| 0805 电阻 | 4.7K | 1 | 搜 4.7K 0805 |
| 0805 电阻 | 10K | 10 | 搜 10K 0805 → C25804 |
| 0805 电阻 | 1K | 1 | 搜 1K 0805 |
| 0805 LED | 绿色 | 1 | 搜 0805 LED 绿 |
| LDO | AMS1117-3.3 | 1 | 搜 AMS1117-3.3 → C6186 |
| MCU 模组 | ESP32-S3-WROOM-1-N4 | 1 | 搜 ESP32-S3-WROOM-1-N4 → C2913201 |
| 模拟开关 | 74HC4051D SOIC-16 | 9 | 搜 74HC4051D |

### 需确认(关键器件)
| 器件 | 数量 | 说明 |
|---|---|---|
| **HAL49E**(SOT-23) | **67** | 霍尔传感器, 磁轴键盘核心件。搜"HAL49E"。若缺货: 可用等效单极霍尔传感器替代(3.3V, SOT-23, 灵敏度匹配), 但需验证灵敏度参数 |
| USB-C 16P 母座 | 1 | HRO 型贴片。搜"TYPE-C 16P 贴片"。确认是 SMT 不是插件 |

### 插件件(嘉立创 SMT 不贴, 到手手焊, 只有 4 个)
| 器件 | 位号 | 数量 | 说明 |
|---|---|---|---|
| 排针 1×3 P2.54 | J2 | 1 | DS18B20 温度接口(如果不用温度功能可不焊) |
| 排针 1×4 P2.54 | J3 | 1 | UART 调试接口 |
| 轻触按键 TS-1187A | SW1(BOOT) | 1 | 固件下载必须焊 |
| 轻触按键 TS-1187A | SW2(EN) | 1 | 复位键 |

## PCBA 下单步骤

1. 嘉立创下单首页 → 找到刚下的 PCB 订单 → 点「**添加 SMT 贴片**」
   (或者: 首页 → PCBA → 上传 BOM + 坐标 + 选关联的 PCB 订单)
2. 上传 BOM: `output/BOM-PCBA-v43b.csv`
3. 上传坐标: `output/PickPlace-PCBA-v43b.csv`
4. 确认贴片面: **TOP 面**
5. 逐项匹配料号(常备料自动匹配, 手动搜标注的 C 号)
6. **HAL49E 67 个**: 确认库存够, 这是全板最大的采购风险
7. 选择"顶部贴片"(所有元件都在 TOP)
8. 提交 → 付款 → 板子+贴片+元件一起回来(焊好的)

## 费用预估
- SMT 开机费: ~¥300-500(首件)
- 物料费: HAL49E×67 是大头(~¥3-5/个 = ¥200-350) + ESP32 模组(~¥15-20) + 其余杂项
- 总计贴片费用: 约 ¥600-900(不含 PCB 打样费)
