bty1987/KeyCore/07-PCB/output/手工收线清单.md

# 手工收线清单 · KeyCore v5.1-prelim（2026-10-03）

> 未通网 78（route_report.json）展开成 **109 条候选段**——同族裸名（USB_DP/USB_DN/VBUS/MUX_A 等）把整族 9 段全部列出，**已布通的段 EDA 飞线会自动消失，跳过即可**。EDA 飞线（未连接网络）是权威清单，本表告诉你每条从哪到哪。
> 坐标系=KiCad 导入后的板内 mm 坐标（原点左下）。全部走 **B.Cu（底层）**，顶层只留母线和器件。LED/U1TX/U1RX/3V3 桥在主控区，直接按坐标连。

| # | 网络 | 起点 (x,y) | 终点 (x,y) | 终点含义 | 线宽 | 直线距 |
|---|---|---|---|---|---|---|
| 1 | USB_DP-A6 | 12.3,16.25 | 50.26,4.0 | 模组脚 | 0.3 | 40mm |
| 2 | USB_DP-B6 | 12.3,15.25 | 50.26,4.0 | 模组脚 | 0.3 | 40mm |
| 3 | CC1 | 12.3,17.25 | 16.59,14.75 | CC1 电阻 | 0.3 | 5mm |
| 4 | CC2 | 13.6,14.25 | 16.59,17.75 | CC2 电阻 | 0.3 | 5mm |
| 5 | EN_1 | 24.09,145.2 | 85,4.05 | 上拉 R1 | 0.25 | 154mm |
| 6 | EN_2 | 54.09,145.2 | 90,4.05 | 上拉 R2 | 0.25 | 146mm |
| 7 | EN_3 | 84.09,145.2 | 95,4.05 | 上拉 R3 | 0.25 | 142mm |
| 8 | EN_4 | 114.09,145.2 | 100,4.05 | 上拉 R4 | 0.25 | 142mm |
| 9 | EN_5 | 164.09,145.2 | 105,4.05 | 上拉 R5 | 0.25 | 153mm |
| 10 | EN_6 | 194.09,145.2 | 87.5,9.05 | 上拉 R6 | 0.25 | 173mm |
| 11 | EN_7 | 224.09,145.2 | 92.5,9.05 | 上拉 R7 | 0.25 | 189mm |
| 12 | EN_8 | 254.09,145.2 | 97.5,9.05 | 上拉 R8 | 0.25 | 208mm |
| 13 | EN_9 | 282.1,145.2 | 102.5,9.05 | 上拉 R9 | 0.25 | 225mm |
| 14 | Z_COM-0 | 27.91,145.2 | 43.7,3.4 | Z 汇流点 | 0.3 | 143mm |
| 15 | Z_COM-1 | 57.91,145.2 | 43.7,3.4 | Z 汇流点 | 0.3 | 143mm |
| 16 | Z_COM-2 | 87.91,145.2 | 43.7,3.4 | Z 汇流点 | 0.3 | 149mm |
| 17 | Z_COM-3 | 117.91,145.2 | 43.7,3.4 | Z 汇流点 | 0.3 | 160mm |
| 18 | Z_COM-4 | 167.91,145.2 | 43.7,3.4 | Z 汇流点 | 0.3 | 189mm |
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
3. **霍尔 OUT**（大头）——按 4051 分组收：每组 8 键从 4051 X 脚出发往回铺；技巧=先从霍尔过孔**垂直下穿**到本行与下一行之间的空隙（y=行母线附近），再**横向**走到组内 4051 的 x 位置，最后**竖直向下**进 X 脚——同组从左到右依次进线，通道互不交叉
4. 收一条在表里划一条；全部划完后跑 DRC（净距 0.2 / 线宽≥0.25 / 过孔 0.6-0.3）清零

## 未映射的 fails（如有）

```
LED, U1RX, U1TX
```
