bty1987/KeyCore/07-PCB/output/final/BOM-PCBA-v43b.csv

Comment | Designator | Footprint | LCSC Part Number
10uF | C_EN,C_IN1,C_M1 | C_0805_2012Metric | C15850
0.1uF | C_IN2,C_M2 | C_0805_2012Metric | C49678
22uF | C_V1,C_V2 | C_0805_2012Metric | C45783
HAL49E | H01,H02,H03,H04,H05,H06,H07,H08,H09,H10,H11,H12,H13,H14,H15,H16,H17,H18,H19,H20,H21,H22,H23,H24,H25,H26,H27,H28,H29,H30,H31,H32,H33,H34,H35,H36,H37,H38,H39,H40,H41,H42,H43,H44,H45,H46,H47,H48,H49,H50,H51,H52,H53,H54,H55,H56,H57,H58,H59,H60,H61,H62,H63,H64,H65,H66,H67 | SOT-23 | C7420984
USB-C 16P | J1 | USB_C_Receptacle_HRO
PinHeader 1x3 (手焊) | J2 | PinHeader_1x03_P2.54
PinHeader 1x4 (手焊) | J3 | PinHeader_1x04_P2.54
LED 绿色 0805 | LED1 | LED_0805_2012Metric | C965812
5.1K | R_CC1,R_CC2 | R_0805_2012Metric | C27834
4.7K | R_DQ | R_0805_2012Metric | C17673
10K | R_E1,R_E2,R_E3,R_E4,R_E5,R_E6,R_E7,R_E8,R_E9,R_E10 | R_0805_2012Metric | C25804
1K | R_LED | R_0805_2012Metric | C17513
BOOT 按键 (手焊) | SW1 | Button_Switch_TS-118
EN 按键 (手焊) | SW2 | Button_Switch_TS-118
ESP32-S3-WROOM-1-N4 | U1 | ESP32-S3-WROOM-1 | C2913197
AMS1117-3.3 | U2 | SOT-223-3_TabPin2 | C6186
74HC4051 | U101,U102,U103,U104,U105,U106,U107,U108,U109 | SOIC-16_3.9x9.9mm_P1.27mm | C2943297
