bty1987/KeyCore/07-PCB/output/DRC收尾清单.md

# DRC 收尾清单（2026-10-05 批量修复后）

## 一、间距违规：已自动修复

- 必修违规（<0.05mm 及全部重叠）已清零：6 个过孔挪位、2 根 3V3 干线织纬绕行（J2/J3 排针、ESP32、LDO、SW1 区）、
  SW1 垂直 3V3 折线绕行、HO_K22 手拉线头回缩、139.09 垂线收端。

## 二、容忍带（0.05~0.089mm，按原型板口径放行，共 7 项）

| 位置 | 间隙 | 说明 |
|---|---|---|
| via EN_7 @(82.81,-21.89) × R_E7.2 | 0.053 | |
| via EN_6 @(77.19,-21.90) × R_E6.2 | 0.062 | |
| via HO_K45 @(249.37,-140.52) × via MUX_B | 0.063 | |
| via 空网 @(117.09,-17.78) × HO_K58 走线 / LED1.1 | 0.068/0.069 | ★该过孔无网络，疑似误放，建议删除 |

## 三、连接性断点（50 网 / 63 处，需手拉补线）

坐标为 EDA 帧 mm（y 负值，与工程内一致）。同网两群之间 Alt+W 补线即可。

### 3V3（11 群，需补 10 根）
- 群1: H01.1(17.65,-69.12), H02.1(36.70,-69.12), H03.1(55.75,-69.12), H04.1(74.80,-69.12), H05.1(93.85,-69.12), H06.1(112.90,-69.12) …共80焊盘
- 群2: H47.1(136.71,-126.28), H48.1(155.76,-126.28), H49.1(174.81,-126.28), H50.1(193.86,-126.28), H51.1(212.91,-126.28), H52.1(231.96,-126.28)
- 群3: H53.1(267.68,-126.28), H60.1(258.16,-145.32)
- 群4: H54.1(20.03,-145.32), H55.1(43.84,-145.32)
- 群5: H42.1(29.56,-126.28)
- 群6: H44.1(79.56,-126.28)
- 群7: H56.1(67.66,-145.32)
- 群8: H57.1(139.09,-145.32)
- 群9: H58.1(210.53,-145.32)
- 群10: H59.1(234.34,-145.32)
- 群11: H61.1(281.97,-145.32)

### GND（4 群，需补 3 根）
- 群1: H01.2(17.65,-67.22), H02.2(36.70,-67.22), H03.2(55.75,-67.22), H04.2(74.80,-67.22), H05.2(93.85,-67.22), H06.2(112.90,-67.22) …共109焊盘
- 群2: U1.1(271.50,-13.74)
- 群3: U1.40(288.50,-13.74)
- 群4: C_EN.2(244.00,-14.95)

### HO_K08（2 群，需补 1 根）
- 群1: H08.3(149.00,-68.17)
- 群2: U103.4(81.36,-31.48)

### HO_K10（2 群，需补 1 根）
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
- 群2: R_CC2.1(157.09,-8.00)

### VBUS（2 群，需补 1 根）
- 群1: J1.B4(152.45,-0.95), J1.A4(147.55,-0.95), J1.B9(147.55,-0.95), J1.A9(152.45,-0.95), C_IN1.2(94.00,-18.95), C_IN2.2(96.50,-18.95)
- 群2: U2.3(96.85,-14.30)

### LED_A（2 群，需补 1 根）
- 群1: LED1.2(118.00,-18.94)
- 群2: R_LED.1(118.00,-13.09)
