bty1987/KeyCore/07-PCB/output/BOM元件绑定归档-20261007.md

# KeyCore-v43b-3c 元件选型与绑定归档

- 日期：2026-10-07
- 工程：KeyCore-v43b-3c（Mac v43b 最终版重导入 + 清线净板）
- 板框：300 × 172 mm，双层板
- 状态：**BOM↔封装↔网络 三重闭环**，111 元件全部对照立创商城完成

---

## 一、最终 BOM（18 项封装 / 111 元件 / 105 个采购件全部带 C 号）

| # | 封装/器件 | C 号 | 厂商 | 数量 | 位号 | 封装状态 |
|---|---|---|---|---|---|---|
| 1 | HAL49ESO（线性霍尔，磁轴键盘用） | **C7420984** | Hallwee 霍尔微电子 | 67 | H01~H67 | SOT-23-3 ✓ 原生匹配 |
| 2 | 74HC4051 | **C2943297** | — | 9 | U101~U109 | SOP-16 标准竖向焊盘（已重绑修正）|
| 3 | ESP32-S3-WROOM-1-**N4R8** | **C2913200** | Espressif 乐鑫 | 1 | U1 | WIRELM-SMD 官方封装（含天线区）已重绑 ✓ |
| 4 | AMS1117-3.3 | **C6186** | AMS 原厂 | 1 | U2 | SOT-223-3 已重绑 ✓ |
| 5 | TYPE-C-31-M-12（卧贴 16P） | **C165948** | 韩国韩荣 HRO | 1 | J1 | 官方焊盘，**口朝板边**（用户 180° 修正）✓ |
| 6 | PZ254V-11-03P（1×3 2.54 直插） | **C2937625** | XFCN 兴飞 | 1 | J2 | DS18B20 探头座 ✓ |
| 7 | PZ254V-11-04P-RD（1×4 2.54 直插） | **C41425294** | XFCN 兴飞 | 1 | J3 | UART 调试口 ✓ |
| 8 | TS-1187A-B-A-B（H1.5 矮体） | **C318884** | XKB 星坤 | 2 | SW1(BOOT)/SW2(EN) | 官方 4 角焊盘已重绑 ✓ |
| 9 | 22uF 0805 25V X5R | **C45783** | 三星 | 2 | C_V1,C_V2 | ✓ |
| 10 | 10uF 0805 50V | **C2932476** | 三星 | 3 | C_IN1,C_EN,C_M1 | ✓ |
| 11 | 0.1uF 0805 50V | **C1711** | 三星 | 2 | C_IN2,C_M2 | ✓ |
| 12 | 10K 0805 1% | **C17414** | 厚声 | 10 | R_EN,R_E1~R_E9 | ✓ |
| 13 | 4.7K 0805 1% | **C17673** | 厚声 | 1 | R_DQ | ✓ |
| 14 | 5.1K 0805 1% | **C27834** | 厚声 | 2 | R_CC1,R_CC2 | ✓ |
| 15 | 1K 0805 1% | **C17513** | 厚声 | 1 | R_LED | ✓ |
| 16 | 红光 LED 0805 | **C54770670** | 亿晶源 | 1 | LED1 | ✓（弃 C2286/0603 不符）|
| 17 | MountingHole_2.7mm | —（结构件不采购） | — | 6 | H1~H6 | — |
| 18 | DS18B20 探头 | 外购件，插 J2 | — | 1 | — | 三线：红 3V3/黄 DATA/黑 GND |

---

## 二、关键引脚定义核对（已定案）

### HAL49ESO（67 颗核心，最高风险项）
- 引脚：**1=VDD、2=GND、3=OUT**（用户对照商城实物确认）
- 板上映射：1=3V3、2=GND、3=HO_Kxx ✓ 全部一致
- 焊盘几何 = SOT-23-3 标准贴片（1/2 同侧 P1.9、3 脚对侧）✓

### U1 = ESP32-S3-WROOM-1-N4R8（注意：N4R8，含 8MB Octal PSRAM）
- 41 脚逐脚对照乐鑫官方：**37 对 + 2 项修正**（LED 挪 IO38 软件可控、pad39 补 GND）
- 高危区全部正确：USB 13/14=IO19/20 ✓、BOOT=27=IO0 ✓、strap 16/26 留空 ✓、**28~30=IO35/36/37 PSRAM 专用正确留空**（R8 内证）
- 遗留说明：pad38 原接 LED（=GND 脚，常亮方案）→ 已改为 IO38 软件可控

### U2 = AMS1117-3.3（1=GND、2=3V3+散热tab、3=VBUS）
### J1 = TYPE-C-31-M-12（1/2 脚 CC、13/14 脚 USB 差分；口朝板边）

---

## 三、发现并修正的原设计错误（共 4 类）

1. **SOIC-16 焊盘方向错**：9 颗 74HC4051 焊盘 1.95mm 长边沿行方向（相邻重叠 0.68mm）→ 已换标准竖向焊盘（U101/U102 用户手动 + 其余批量重绑）
2. **USB-C 口朝向反**：Mac 原版 J1 插口朝板内（线缆无法插拔）→ 用户手动旋转 180° 并外移 1.07mm 修正 ✓
3. **按键封装错**：TS-1187A 焊盘应为 3.7/6.5 排布，原板 5.2×2.8 对不上实物 → 已重绑 C318884 官方封装（H1.5 矮体适配屏幕下方）✓
4. **LED 位置非最优**：LED 接在 pad38（GND 脚）= 常亮不可控 → 已挪 IO38 软件可控 ✓；pad39 空脚补 GND ✓

---

## 四、验证方法与证据链

| 手段 | 覆盖 |
|---|---|
| 逐脚网络绑定回读（add-component bindingVerified + assignedNets） | 全部重绑件（67+9+1+1+20+2）|
| 画布高倍渲染实测（焊盘形态/本体/网络标号） | U1、U2、SW1/2、J1、H 阵列 |
| 41 脚引脚表对照（乐鑫官方） | U1 全部 |
| 数据手册封装图 + 实物照片（用户对照商城） | HAL49ESO、74HC4051、J1 |
| 焊盘坐标几何比对（5.2×2.8 vs 3.7/6.5 等 mismatches） | 按键、SOIC、霍尔 |
| Gerber 焊盘簇实测（中置壳脚贴板边 0.13mm） | J1 口朝向 |

> 注：嘉立创 DFM 只保证可制造性，不校验功能正确性（引脚映射/口朝向/封装镜像均不报）——正确性唯一来源 = 与数据手册及商城实物的逐项比对。

---

## 五、遗留待办

1. **机械三要素核对**：屏幕型号/尺寸、亚克力板尺寸、键位与霍尔阵列（6 行 67 键）位置关系——需用户提供图纸
2. **J1 外移 1.07mm**：外壳 USB-C 开孔按新位置核对
3. **SW 按键高度**：H1.5mm 与外壳按压柱配合核对
4. **电源策略**：Mac 原版为双层板；如需电源平面（In1/In2）在画线前决策
5. 以上全部闭环 → **开始画线**

---

## 六、过程要点（存档备查）

- 净板准备：Mac epro2 由用户重导入为 KeyCore-v43b-3c；agent 执行 `pcb clear-routing`（2805 走线+589 过孔清零，111 元件保留）
- 规则基线：viaSize 复位 + 0.089mm 间距矩阵 + POUR 电源平面在 2b 会话已验证流程（本版按需重放）
- 修正执行方式：typed 删旧→add-component 库器件→逐脚绑网（bindingVerified 验收），NC 脚省略
- 已知工具坑：delete 需删后重列表验证；DRC 内部 ID ≠ primitiveId；库器件绑定后 dump 读不到焊盘（画布为真）；对话框预览缩略图会误导，判定以板面渲染+坐标为准
