bty1987/KeyCore/02-结构图纸/keycap-v5.3-1u-图纸.dxf

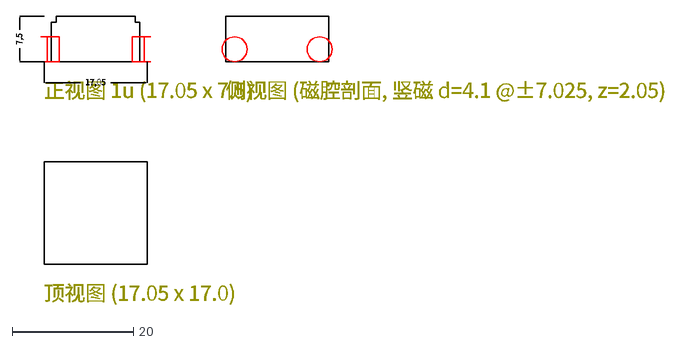
[picture p22: CAD file, 2026-10-17]
02-结构图纸/keycap-v5.3-1u-图纸.dxf
正视图 1u (17.05 x 7.5)
17,05
7,5
侧视图 (磁腔剖面, 竖磁 d=4.1 @±7.025, z=2.05)
顶视图 (17.05 x 17.0)
