bty1987/KeyCore/02-结构图纸/export-chassis-v3.1.stl

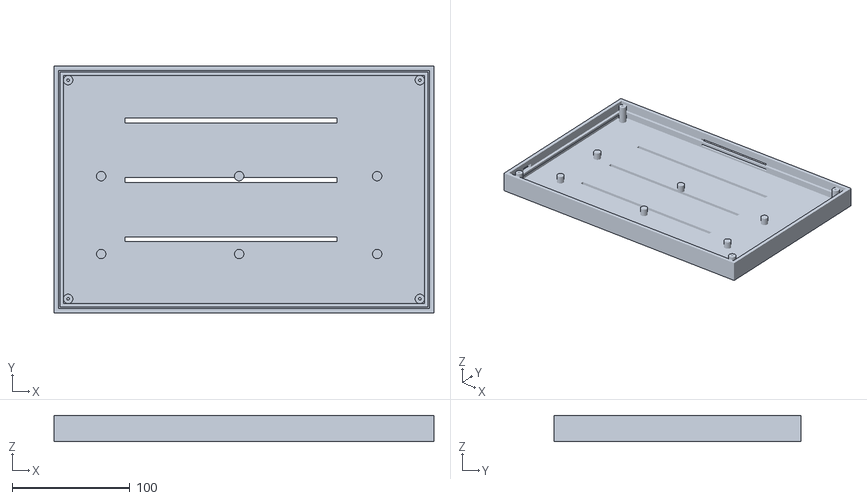
[picture p23: CAD file, 2026-10-05]
02-结构图纸/export-chassis-v3.1.stl
322.2 x 209.4 x 22.1
