bty1987/KeyCore/02-结构图纸/export-thickplate.stl

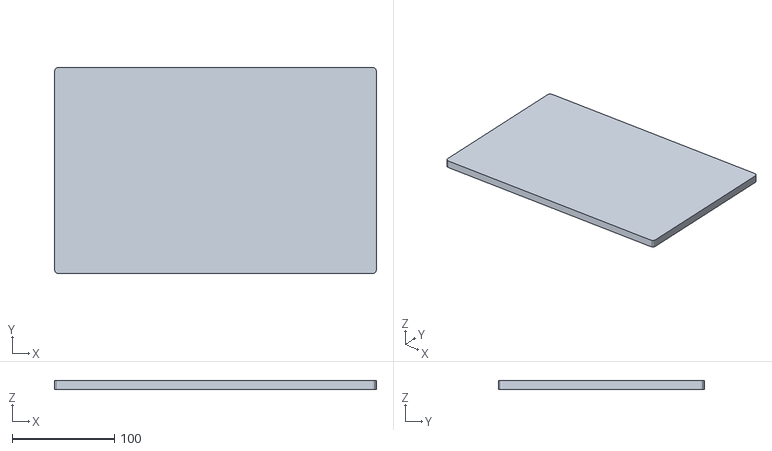
[picture p24: CAD file, 2026-10-05]
02-结构图纸/export-thickplate.stl
314.2 x 201.4 x 9.00
