bty1987/KeyCore/02-结构图纸/thickplate-v6.scad

// ============================================================
// 厚板 v6 · 2026-10-17 终版（用户拍板：无任何贯通开口，磁槽全在底面）
//   取代 v5 的 6 条行磁道 → 改为 底面盲槽 ×73（2.2×4.2，深 4，自底面向上铣）
//   磁铁 N52 4×2 竖放，自底面装入盲槽胶固（M1-M73 独立装填，无贯通）
//     磁心 z2 —— 距 PCB 霍尔更近，感应更优
//   板 = 300.2×192×9（四角 R4）；67 孔打穿（键帽悬浮位，与封板 5c 霍尔位零偏差）
//   盲槽顶 z4，上方留 5mm 实体；全板无任何对外开口
//   制造：CNC（正面钻 67 孔 + 底面铣 73 盲槽，两面工序）
// 坐标系：scad = EDA 帧映射（y_scad = 192 + EDA_y_mm，y-up）
// ============================================================

plate_w = 300.2;
plate_d = 192.0;
plate_t = 9.0;
hole_r  = 2.0;

frame_holes = [[16.523, 111.538, 1], [35.573, 111.538, 1], [54.623, 111.538, 1], [73.673, 111.538, 1], [92.723, 111.538, 1], [111.773, 111.538, 1], [16.523, 92.488, 1], [35.573, 92.488, 1], [54.623, 92.488, 1], [73.673, 92.488, 1], [92.723, 92.488, 1], [111.773, 92.488, 1], [130.823, 92.488, 1], [149.873, 92.488, 1], [168.923, 92.488, 1], [187.973, 92.488, 1], [207.023, 92.488, 1], [226.073, 92.488, 1], [245.123, 92.488, 1], [273.698, 92.488, 2], [21.285, 73.438, 1.5], [45.098, 73.438, 1], [64.148, 73.438, 1], [83.198, 73.438, 1], [102.248, 73.438, 1], [121.298, 73.438, 1], [140.348, 73.438, 1], [159.398, 73.438, 1], [178.448, 73.438, 1], [197.498, 73.438, 1], [216.548, 73.438, 1], [235.598, 73.438, 1], [254.648, 73.438, 1], [278.46, 73.438, 1.5], [23.668, 54.388, 1.75], [49.86, 54.388, 1], [68.91, 54.388, 1], [87.96, 54.388, 1], [107.01, 54.388, 1], [126.06, 54.388, 1], [145.11, 54.388, 1], [164.16, 54.388, 1], [183.21, 54.388, 1], [202.26, 54.388, 1], [221.31, 54.388, 1], [240.36, 54.388, 1], [271.318, 54.388, 2.25], [28.43, 35.338, 2.25], [59.385, 35.338, 1], [78.435, 35.338, 1], [97.485, 35.338, 1], [116.535, 35.338, 1], [135.585, 35.338, 1], [154.635, 35.338, 1], [173.685, 35.338, 1], [192.735, 35.338, 1], [211.785, 35.338, 1], [230.835, 35.338, 1], [266.555, 35.338, 2.75], [18.905, 16.288, 1.25], [42.718, 16.288, 1.25], [66.53, 16.288, 1.25], [137.968, 16.288, 6.25], [209.405, 16.288, 1.25], [233.218, 16.288, 1.25], [257.03, 16.288, 1.25], [280.843, 16.288, 1.25]];

mag_positions = [[7.0, 16.288], [30.81, 16.288], [54.62, 16.288], [78.44, 16.288], [197.5, 16.288], [221.31, 16.288], [245.12, 16.288], [268.94, 16.288], [292.75, 16.288], [7.0, 35.338], [49.86, 35.338], [68.91, 35.338], [87.96, 35.338], [107.01, 35.338], [126.06, 35.338], [145.11, 35.338], [164.16, 35.338], [183.21, 35.338], [202.26, 35.338], [221.31, 35.338], [240.36, 35.338], [292.75, 35.338], [7.0, 54.388], [40.34, 54.388], [59.38, 54.388], [78.43, 54.388], [97.48, 54.388], [116.53, 54.388], [135.59, 54.388], [154.64, 54.388], [173.69, 54.388], [192.74, 54.388], [211.78, 54.388], [230.84, 54.388], [249.89, 54.388], [292.75, 54.388], [7.0, 73.438], [35.57, 73.438], [54.62, 73.438], [73.67, 73.438], [92.72, 73.438], [111.77, 73.438], [130.82, 73.438], [149.87, 73.438], [168.92, 73.438], [187.97, 73.438], [207.02, 73.438], [226.07, 73.438], [245.12, 73.438], [264.17, 73.438], [292.75, 73.438], [7.0, 92.488], [26.05, 92.488], [45.1, 92.488], [64.15, 92.488], [83.2, 92.488], [102.25, 92.488], [121.3, 92.488], [140.35, 92.488], [159.4, 92.488], [178.45, 92.488], [197.5, 92.488], [216.55, 92.488], [235.6, 92.488], [254.65, 92.488], [292.75, 92.488], [7.0, 111.538], [26.05, 111.538], [45.1, 111.538], [64.15, 111.538], [83.2, 111.538], [102.25, 111.538], [121.3, 111.538]];
pocket_x = 2.2;
pocket_y = 4.2;
pocket_d = 4.0;

module through_hole(x, y, wu) {
  hw = wu*19.05 - 2.0 + 0.6;
  translate([x, y, -0.1])
    linear_extrude(plate_t + 0.2)
      hull() for (sx=[-1,1], sy=[-1,1])
        translate([sx*(hw/2-hole_r), sy*(hw/2-hole_r)]) circle(r=hole_r, $fn=48);
}
module all_holes() for (p = frame_holes) through_hole(p[0], p[1], p[2]);

module mag_pockets() {
  for (m = mag_positions)
    translate([m[0] - pocket_x/2, m[1] - pocket_y/2, -0.1])
      linear_extrude(pocket_d + 0.1)
        offset(r = 0.5) square([pocket_x - 1.0, pocket_y - 1.0], center = true);
}

module thick_plate() {
  difference() {
    translate([4, 4, 0]) linear_extrude(plate_t)
      offset(r=4) square([plate_w-8, plate_d-8]);
    all_holes();
    mag_pockets();
  }
}

thick_plate();
