bty1987/KeyCore/(list of files, cad)

Other CAD files:
02-结构图纸/chassis-v3.1.scad
02-结构图纸/thickplate-v3.scad
02-结构图纸/thickplate-v4.scad
02-结构图纸/thickplate-v5.scad
