bty1987/KeyCore/05-效果图/v3-装配关系图.png

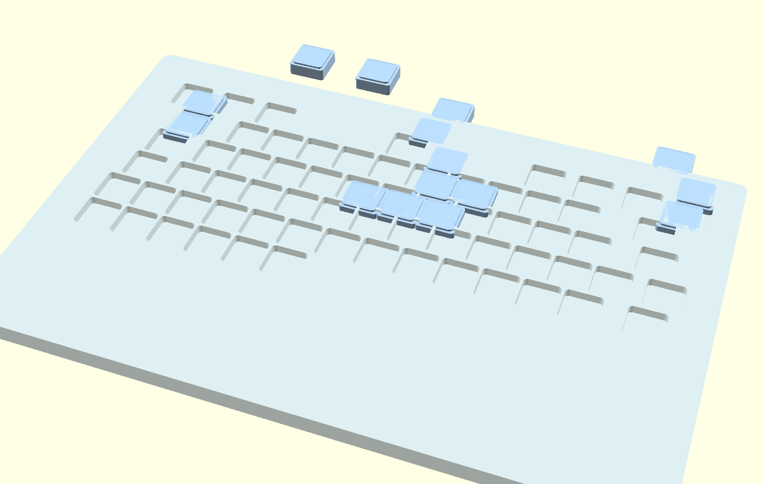
05-效果图/v3-装配关系图.png
