bty1987/KeyCore/07-PCB/output/KeyCore-v44.kicad_pcb

## KiCad design 07-PCB/output/KeyCore-v44.kicad_pcb (2026-10-08)

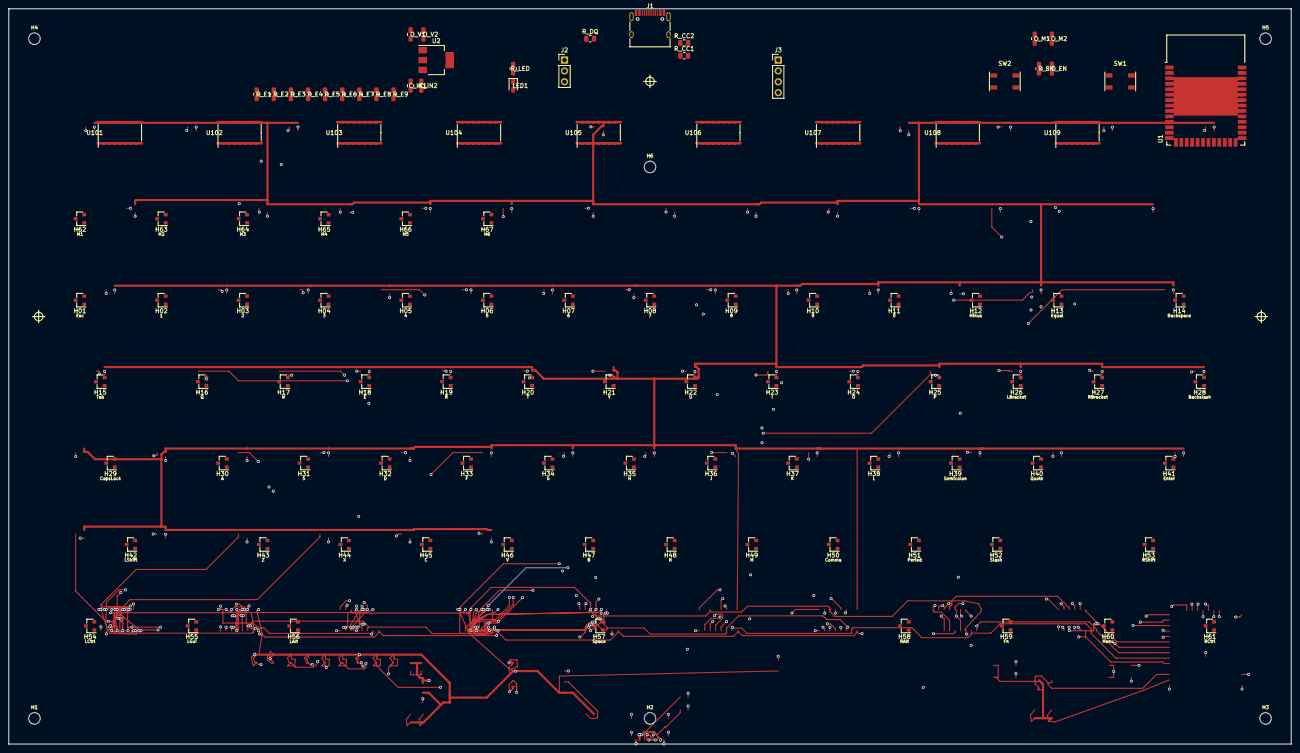
[picture p26: board KeyCore-v44.kicad_pcb from above]

Board: 4 copper layers, 300.0 x 172.0 mm, 111 parts (0 on the bottom side), 94 nets.

Parts:
C_EN: 10uF; C_0805_2012Metric
C_IN1: 10uF; C_0805_2012Metric
C_IN2: 0.1uF; C_0805_2012Metric
C_M1: 10uF; C_0805_2012Metric
C_M2: 0.1uF; C_0805_2012Metric
C_V1, C_V2: 22uF; C_0805_2012Metric
H01, H02, H03, H04, H05, H06, H07, H08, H09, H10, H11, H12, H13, H14, H15, H16, H17, H18, H19, H20, H21, H22, H23, H24, H25, H26, H27, H28, H29, H30, H31, H32, H33, H34, H35, H36, H37, H38, H39, H40, H41, H42, H43, H44, H45, H46, H47, H48, H49, H50, H51, H52, H53, H54, H55, H56, H57, H58, H59, H60, H61, H62, H63, H64, H65, H66, H67: HAL49E; SOT-23
H1, H2, H3, H4, H5, H6: MountingHole_2.7mm
J1: USB-C 16P; USB_C_Receptacle_HRO_TYPE-C-31-M-12
J2: DS18B20; PinHeader_1x03_P2.54mm_Vertical
J3: UART1; PinHeader_1x04_P2.54mm_Vertical
LED1: PWR; LED_0805_2012Metric
R_CC1, R_CC2: 5.1K; R_0805_2012Metric
R_DQ: 4.7K; R_0805_2012Metric
R_E1, R_E2, R_E3, R_E4, R_E5, R_E6, R_E7, R_E8, R_E9: 10K; R_0805_2012Metric
R_EN: 10K; R_0805_2012Metric
R_LED: 1K; R_0805_2012Metric
SW1: BOOT; Button_Switch_TS-1187A
SW2: EN; Button_Switch_TS-1187A
U1: ESP32-S3-WROOM-1-N4; ESP32-S3-WROOM-1
U2: AMS1117-3.3; SOT-223-3_TabPin2
U101, U102, U103, U104, U105, U106, U107, U108, U109: 74HC4051; SOIC-16_3.9x9.9mm_P1.27mm

Connections:
3V3: C_M1.1, C_M2.1, C_V1.1, C_V2.1, H01.1, H02.1, H03.1, H04.1, H05.1, H06.1, H07.1, H08.1, H09.1, H10.1, H11.1, H12.1, H13.1, H14.1, H15.1, H16.1, H17.1, H18.1, H19.1, H20.1, H21.1, H22.1, H23.1, H24.1, H25.1, H26.1, H27.1, H28.1, H29.1, H30.1, H31.1, H32.1, H33.1, H34.1, H35.1, H36.1, H37.1, H38.1, H39.1, H40.1, H41.1, H42.1, H43.1, H44.1, H45.1, H46.1, H47.1, H48.1, H49.1, H50.1, H51.1, H52.1, H53.1, H54.1, H55.1, H56.1, H57.1, H58.1, H59.1, H60.1, H61.1, H62.1, H63.1, H64.1, H65.1, H66.1, H67.1, J2.1, J3.3, LED1.1, R_DQ.2, R_E1.2, R_E2.2, R_E3.2, R_E4.2, R_E5.2, R_E6.2, R_E7.2, R_E8.2, R_E9.2, R_EN.2, U1.2, U2.2, U101.16, U102.16, U103.16, U104.16, U105.16, U106.16, U107.16, U108.16, U109.16
BOOT: SW1.1, SW1.2, U1.27
CC1: J1.A5, R_CC1.1
CC2: J1.B5, R_CC2.1
EN: C_EN.1, R_EN.1, SW2.1, SW2.2, U1.3
EN_1: R_E1.1, U1.12, U101.6
EN_2: R_E2.1, U1.17, U102.6
EN_3: R_E3.1, U1.18, U103.6
EN_4: R_E4.1, U1.19, U104.6
EN_5: R_E5.1, U1.20, U105.6
EN_6: R_E6.1, U1.21, U106.6
EN_7: R_E7.1, U1.22, U107.6
EN_8: R_E8.1, U1.8, U108.6
EN_9: R_E9.1, U1.9, U109.6
GND: C_EN.2, C_IN1.1, C_IN2.1, C_M1.2, C_M2.2, C_V1.2, C_V2.2, H01.2, H02.2, H03.2, H04.2, H05.2, H06.2, H07.2, H08.2, H09.2, H10.2, H11.2, H12.2, H13.2, H14.2, H15.2, H16.2, H17.2, H18.2, H19.2, H20.2, H21.2, H22.2, H23.2, H24.2, H25.2, H26.2, H27.2, H28.2, H29.2, H30.2, H31.2, H32.2, H33.2, H34.2, H35.2, H36.2, H37.2, H38.2, H39.2, H40.2, H41.2, H42.2, H43.2, H44.2, H45.2, H46.2, H47.2, H48.2, H49.2, H50.2, H51.2, H52.2, H53.2, H54.2, H55.2, H56.2, H57.2, H58.2, H59.2, H60.2, H61.2, H62.2, H63.2, H64.2, H65.2, H66.2, H67.2, J1.A1, J1.A12, J1.B1, J1.B12, J1.S1, J2.3, J3.4, R_CC1.2, R_CC2.2, SW1.3, SW1.4, SW2.3, SW2.4, U1.1, U1.40, U1.41, U2.1, U101.7, U101.8, U102.7, U102.8, U103.7, U103.8, U104.7, U104.8, U105.7, U105.8, U106.7, U106.8, U107.7, U107.8, U108.7, U108.8, U109.7, U109.8
HO_K01: H01.3, U103.13
HO_K02: H02.3, U103.14
HO_K03: H03.3, U103.15
HO_K04: H04.3, U103.12
HO_K05: H05.3, U103.1
HO_K06: H06.3, U103.5
HO_K07: H07.3, U103.2
HO_K08: H08.3, U103.4
HO_K09: H09.3, U104.13
HO_K10: H10.3, U104.14
HO_K11: H11.3, U104.15
HO_K12: H12.3, U104.12
HO_K13: H13.3, U104.1
HO_K14: H14.3, U104.5
HO_K15: H15.3, U105.13
HO_K16: H16.3, U105.14
HO_K17: H17.3, U105.15
HO_K18: H18.3, U105.12
HO_K19: H19.3, U105.1
HO_K20: H20.3, U105.5
HO_K21: H21.3, U105.2
HO_K22: H22.3, U105.4
HO_K23: H23.3, U106.13
HO_K24: H24.3, U106.14
HO_K25: H25.3, U106.15
HO_K26: H26.3, U106.12
HO_K27: H27.3, U106.1
HO_K28: H28.3, U106.5
HO_K29: H29.3, U107.13
HO_K30: H30.3, U107.14
HO_K31: H31.3, U107.15
HO_K32: H32.3, U107.12
HO_K33: H33.3, U107.1
HO_K34: H34.3, U107.5
HO_K35: H35.3, U107.2
HO_K36: H36.3, U107.4
HO_K37: H37.3, U108.13
HO_K38: H38.3, U108.15
HO_K39: H39.3, U108.1
HO_K40: H40.3, U108.2
HO_K41: H41.3, U108.4
HO_K42: H42.3, U109.13
HO_K43: H43.3, U109.14
HO_K44: H44.3, U109.15
HO_K45: H45.3, U109.12
HO_K46: H46.3, U109.1
HO_K47: H47.3, U109.5
HO_K48: H48.3, U109.2
HO_K49: H49.3, U109.4
HO_K50: H50.3, U108.14
HO_K51: H51.3, U108.12
HO_K52: H52.3, U108.5
HO_K53: H53.3, U106.4
HO_K54: H54.3, U101.14
HO_K55: H55.3, U101.12
HO_K56: H56.3, U102.13
HO_K57: H57.3, U102.14
HO_K58: H58.3, U102.15
HO_K59: H59.3, U102.12
HO_K60: H60.3, U102.1
HO_K61: H61.3, U102.5
HO_K62: H62.3, U101.13
HO_K63: H63.3, U101.15
HO_K64: H64.3, U101.1
HO_K65: H65.3, U101.5
HO_K66: H66.3, U101.2
HO_K67: H67.3, U101.4
LED: R_LED.2, U1.38
LED_A: LED1.2, R_LED.1
MUX_A: U1.5, U101.11, U102.11, U103.11, U104.11, U105.11, U106.11, U107.11, U108.11, U109.11
MUX_B: U1.6, U101.10, U102.10, U103.10, U104.10, U105.10, U106.10, U107.10, U108.10, U109.10
MUX_C: U1.7, U101.9, U102.9, U103.9, U104.9, U105.9, U106.9, U107.9, U108.9, U109.9
ONE_WIRE: J2.2, R_DQ.1, U1.23
U1RX: J3.2, U1.11
U1TX: J3.1, U1.10
USB_DN: J1.A7, J1.B7, U1.13
USB_DP: J1.A6, J1.B6, U1.14
VBUS: C_IN1.2, C_IN2.2, J1.A4, J1.A9, J1.B4, J1.B9, U2.3
Z_COM: U101.3, U102.3, U103.3, U104.3, U105.3, U106.3, U107.3, U108.3, U109.3
