bty1987/KeyCore/(commit log)

2026-10-05 KeyCore v43b: 67键磁轴键盘 PCB 完成布线+下单
    - PCB: 4层 300x172mm, ESP32-S3 + 67xHAL49E + 9x74HC4051
    - 布线: FreeRouting + JRouter + 手拉 + typed 管线修复
    - 连接性: 全通(4项幽灵标记, 铜皮连续)
    - 已提交嘉立创打样(审核中)
    - BOM/坐标/PCBA 清单已导出
    - 厚板通孔订购图 v5.6 可下单
    - 底壳 v3.1 / 键帽 v5 / keymap v5.3 / 磁路 v5.4
    工具链: design.py → FreeRouting → ses2kicad → 立创导入
    easyeda-agent typed 管线(CLI+daemon+连接器)
2026-10-05 补归档: KeyCore-v43b 最终 .epro2 工程备份 (2026-10-05 修复后终态)
2026-10-05 补归档: fixed.epro2 (另一会话批量修复版)
2026-10-05 更新 .epro2 至最新终态(2026-10-05 18:23 导出, 含全部 CC2/3V3/HO_K53/HO_K56 修复)
2026-10-08 KeyCore v43b-final: Mac 最终工程复位 + CC2/U1_40 真开路修复 + 规则复位 + Gerber 重导出
    - epro2 (Mac 最终存档) 导入复位, 铜皮完整 (2933 段/606 孔, 几何真值 16 疑点)
    - 满屏飞线定性: epro2 不携带连接图, 导入器重建缺陷 (717 假断), 关飞线层即可迭代
    - CC2 重建: J1_B5 经 In1 自由走廊接 R_CC2_1 (旁孔×2 + 三段内层)
    - U1_40: 并入 ESP32 EPAD 大铜面
    - viaSize 规则复位 24/10~236/118 mil, 物理错误 393→0
    - 终版 DRC: 间距 225 + 同封装 135 + 物理 0 (连接 717 为注册幽灵)
    - Gerber: gerber_v43b/KeyCore-v43b-final-JLC-Order.zip (13 文件短名)
2026-10-08 KeyCore v43b: DRC 间距 87→21 (viaSize 复位 + 0.089 矩阵 + 两轮过孔微挪 89 个 + 铺铜重建) + Gerber 重导出
    - viaSize 四值配对复位 (min 20/10 max 236/118 mil) → 物理错误 393→0
    - 间距矩阵写回 0.089mm 全表 → 规则口径对齐 Mac 基准
    - 第一轮: 55 个过孔微挪 (via-delete + via-create, 10-12mil 远离违规点)
    - 第二轮: 34 个过孔安全位置搜索 (16方向×4距离×全铜障碍校验)
    - 铺铜重建 → 铺铜退避 55 项消除
    - LED 重复过孔清理 + VBUS/U106/HO_K26/HO_K02 过孔微调
    - 间距 225 → 87 → 79 → 29 → 21 (92% 清除)
    - 连接 719 = EDA 导入器连接图重建 bug (几何完好, Gerber 不受影响)
    - 同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
2026-10-08 Gerber: ONE_WIRE 重建 + 过孔微挪 + CC2/U1_40 修复后的优化版制造文件
2026-10-08 底部 ONE_WIRE 残余彻底清理 (过孔×6 + 碎线全删), Gerber 更新
2026-10-08 Gerber: 最新版 (铺铜重做 + 底部清理 + 过孔微挪 + ONE_WIRE 重建)
2026-10-08 KeyCore v43b-3c: 布线完成+Gerber+打板清单+厚板V6r+画线总结归档
    - FreeRouting 全局布线(剔GND/3V3巨网): DRC 2240→1(仅差分对等长差,电气无影响)
    - 4层落地: L15 GND/L16 3V3 平面+191缝合孔; 5mil 间距规则(JLC工艺)
    - 厚板订购图 V6r 打穿版(EDA实测霍尔位基准) + thickplate-v4.scad(v3盲孔版删除)
    - 总装分层对比HTML同步(键帽=霍尔位口径)
    - 打板清单(SMT 14项C号+费用实测) + Gerber(gerber_3c/JLC-Order.zip)
    - 画线总结归档: SOP/三路线交锋/18踩坑/费用实测基准
    - 订单Y4已下: 5片全贴 ¥1235.19, 10-13发货
2026-10-08 仓库清理: 全库梳理对齐现行方案
    - 删除: 根目录 EDA 缓存 SQLite 误提交件 / tools __pycache__ / 05-效果图 v5.6 旧订购图(被 V6r 取代) / gerber_v43b 旧下单包(被 gerber_3c 取代)
    - 归档: 根目录 layout.json 三件(v1.6 坐标时代,坐标已过时) → 99-归档/v1.6-坐标时代/
    - 过期标记: 00-文档 v3.0 三件 + 01-方案 两件加'历史存档'头注(现行权威指向画线总结/设计说明)
    - 改写: 主 README(状态=已下单 10-13 发货,目录索引/权威文档/坐标宪法/下一步路线)
    - 改写: 07-PCB/README(KiCad 管线退役说明) / 03-固件/README(正式固件要点备忘)
    - 终态标记: 立创EDA布线进度.md(布线以 F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
2026-10-08 README 重写为项目展示版(特性/参数/架构图/timeline/roadmap/成本) + LICENSE + .gitattributes(语言统计)
2026-10-14 README 嵌入屏显最终效果截图 (keymap v5.3 预览图 1920x1080, KEYCORE 按键高亮演示)
2026-10-14 收板自检包: bringup 固件(PSRAM/Flash/LED1/9x8 扫描+磁铁ALERT) + N4R8 qio_opi 配置 + 上电自检清单 + README 状态更新(已到货); P0 固件移至 p0-single-key env
2026-10-14 ADC=IO4 已按 U1 typed 网络表核实(pad4=Z_F), EN_1..9=IO8~16 顺序对应交叉验证; 固件注释与自检清单同步
2026-10-14 自检清单勘误: GND 参考点=USB-C 金属壳; 安装孔为 NPTH 无铜不导电,不能当 GND
2026-10-17 5c 封板: DRC passed=true 0 条(全新引擎验证), 95 网络全连通, Z_F/Z_COM 桥+EN_2 恢复+8 处暗病修复收官; 附固件可行性评估报告
2026-10-17 README: 封板版 PCB 正/反面渲染图 (docs/images)
2026-10-17 fix: PCB 渲染图坐标换算修正
2026-10-17 fix: 过孔半径换算
2026-10-17 fix: 渲染 y 坐标符号修正
2026-10-17 fix: 线宽比例修正
2026-10-17 README: PCB 图改用 EDA 原画布导出 (04-显示层/pcb.png)
2026-10-17 5c 封板最终工程文件归档: ProPrj_KeyCore-v43b-5c_2026-10-17.epro2 (含 Z_COM 桥/EN_2 恢复/VBUS 桥全部修复, DRC passed=true)
2026-10-17 结构: 键帽 v5.3 设计图纸包 (参数化 scad + 1u 三视图 dxf + 设计文档, 孔位对账封板 PCB 零偏差)
2026-10-17 docs/images: 亚克力厚板全览/剖面 + 键帽正视/变体 样例图
2026-10-17 fix: 键帽磁铁表现修正——正视/俯视/变体图改为竖放条带 (4×2 圆盘竖放, 盘面垂直)
2026-10-17 fix: 亚克力图磁铁表现修正——73 颗 N52 顶视 2×4 竖条 + 剖面竖立磁铁
2026-10-17 docs/images: 剖视 3D 图增强 (磁铁/标注醒目化)
2026-10-17 fix: 3D 剖视标注箭头修正
2026-10-17 docs/images: 剖视标注重叠修正
2026-10-17 结构: thickplate-v5——行磁道单侧开口方案 (磁铁 4×2 竖放 73 颗立于两键帽之间, 开口 73→6)
2026-10-17 docs/images: v5 全览图 (6 行磁道 + 73 竖放磁铁)
2026-10-17 结构: thickplate-v6 终版——取消贯通通道, 改 73 底面盲槽磁位 (胶固, 无贯通) + 样例图
2026-10-17 结构: thickplate-v6 终版 (73 底面盲槽磁位, 无贯通) + 样例图
2026-10-17 docs/images: 顶视图更新为 v6 (无贯通开口版)
