bty1987/KeyCore/(notices)

Notices in the files:
README.md:
License: TBD
